robidev/mini_substation_automation/docs/hardware/hmi_pc/hmi_connections.txt

asus EEE pc
network-connection
power adapter

ram
disk
processor
