robidev/mini_substation_automation/docs/hardware/protection_relay/rpi_connections.txt

pinout serial(uart5)
pinout lcd (spi/i2c)
power
ethernet
