robidev/mini_substation_automation/docs/hardware/switchyard/rpi_connections.txt

servo hat
uart+gnd
14 outputs
10 servo's
5v psu
micro-usb
usb-a to arduino
