robidev/mini_substation_automation/docs/build_steps/2_mechanics/20250916_203245.min.jpg

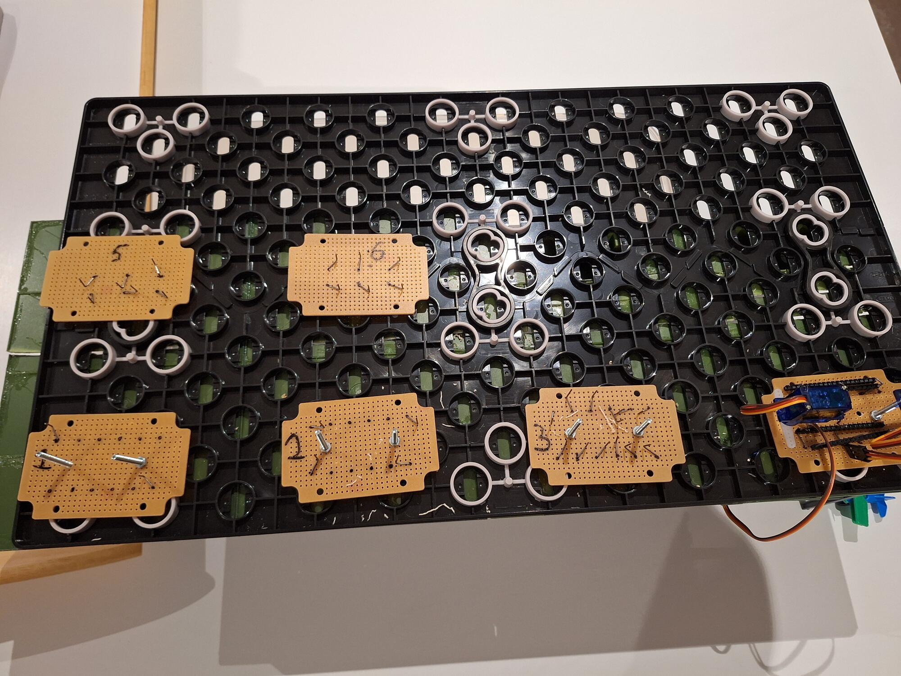
docs/build_steps/2_mechanics/20250916_203245.min.jpg
