robidev/mini_substation_automation/docs/build_steps/2_mechanics/20250917_221358.min.jpg

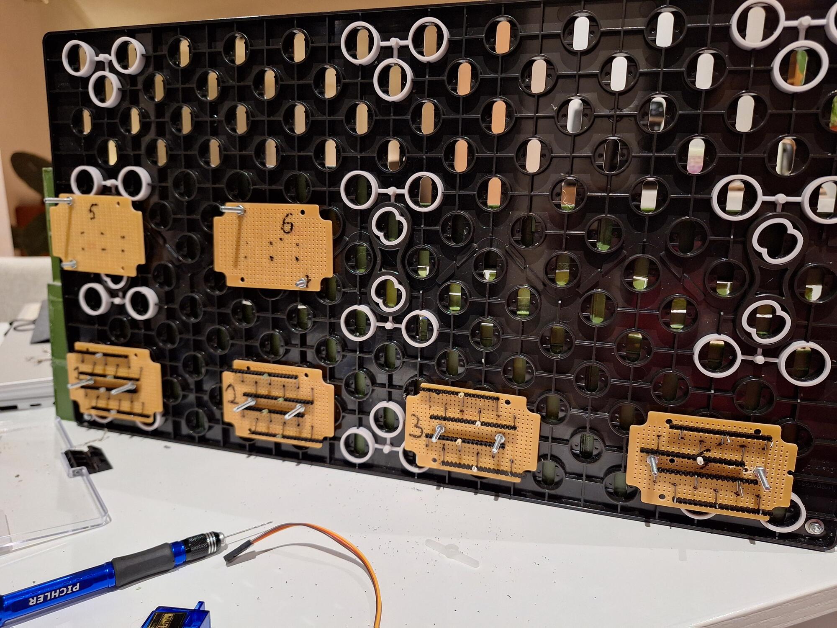
docs/build_steps/2_mechanics/20250917_221358.min.jpg
