robidev/mini_substation_automation/docs/build_steps/4_electronics/20250921_212938.min.jpg

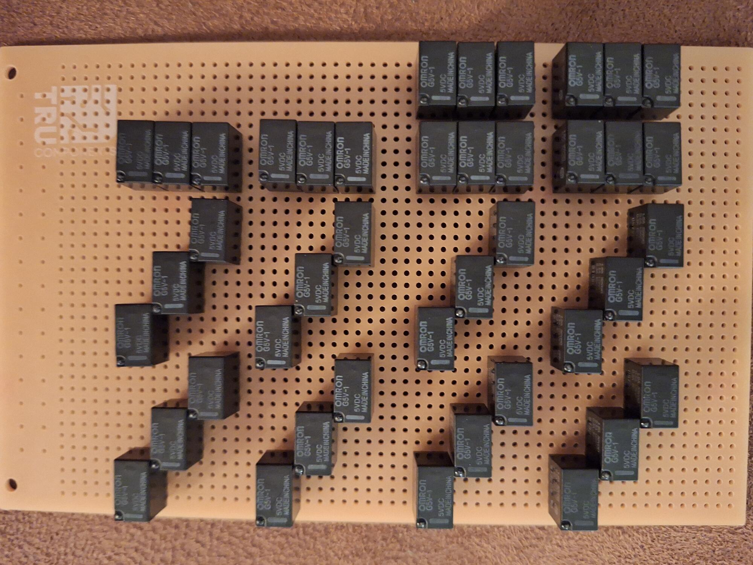
docs/build_steps/4_electronics/20250921_212938.min.jpg
