robidev/mini_substation_automation/docs/build_steps/4_electronics/20250926_090544.min.jpg

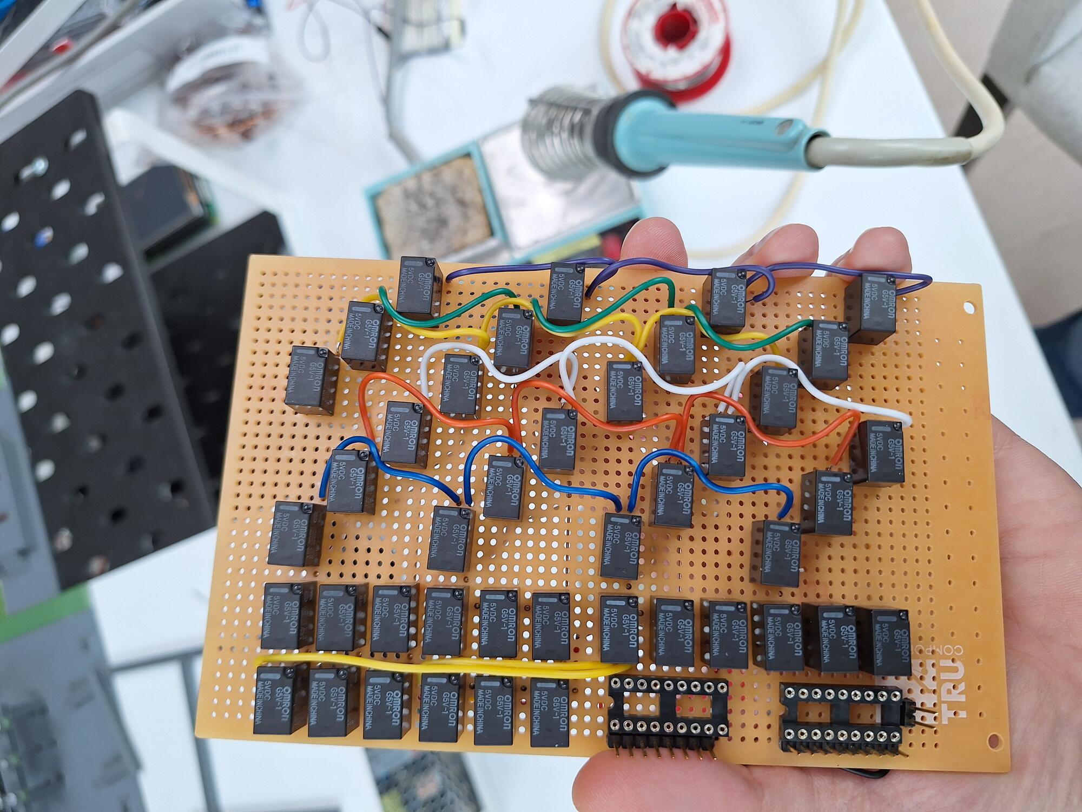
docs/build_steps/4_electronics/20250926_090544.min.jpg
