robidev/mini_substation_automation/docs/build_steps/4_electronics/20250927_000911.min.jpg

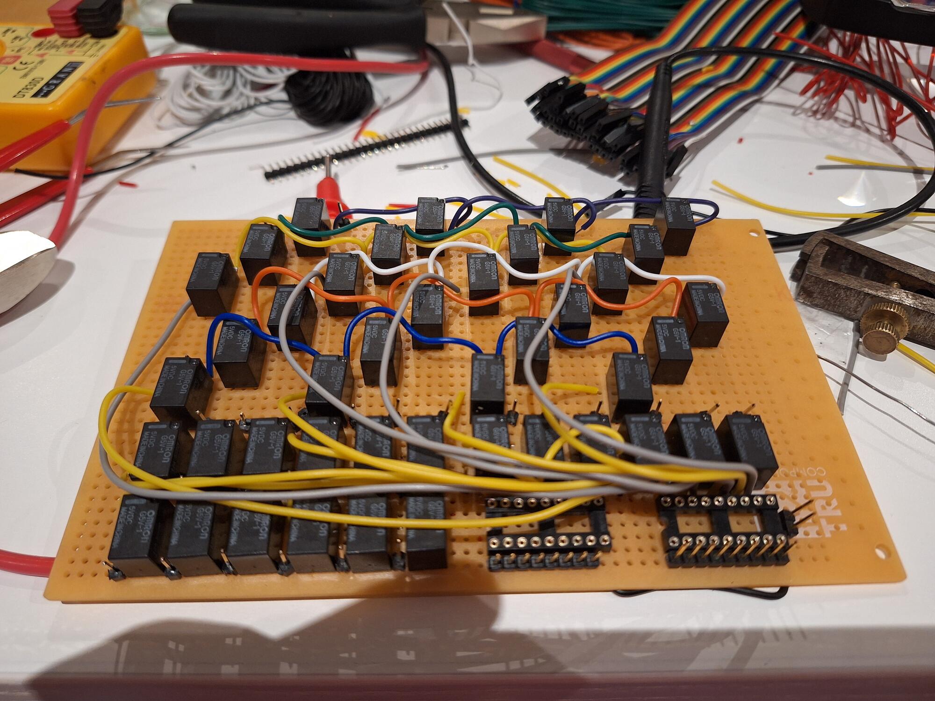
docs/build_steps/4_electronics/20250927_000911.min.jpg
