robidev/mini_substation_automation/docs/build_steps/4_electronics/20251019_193319.min.jpg

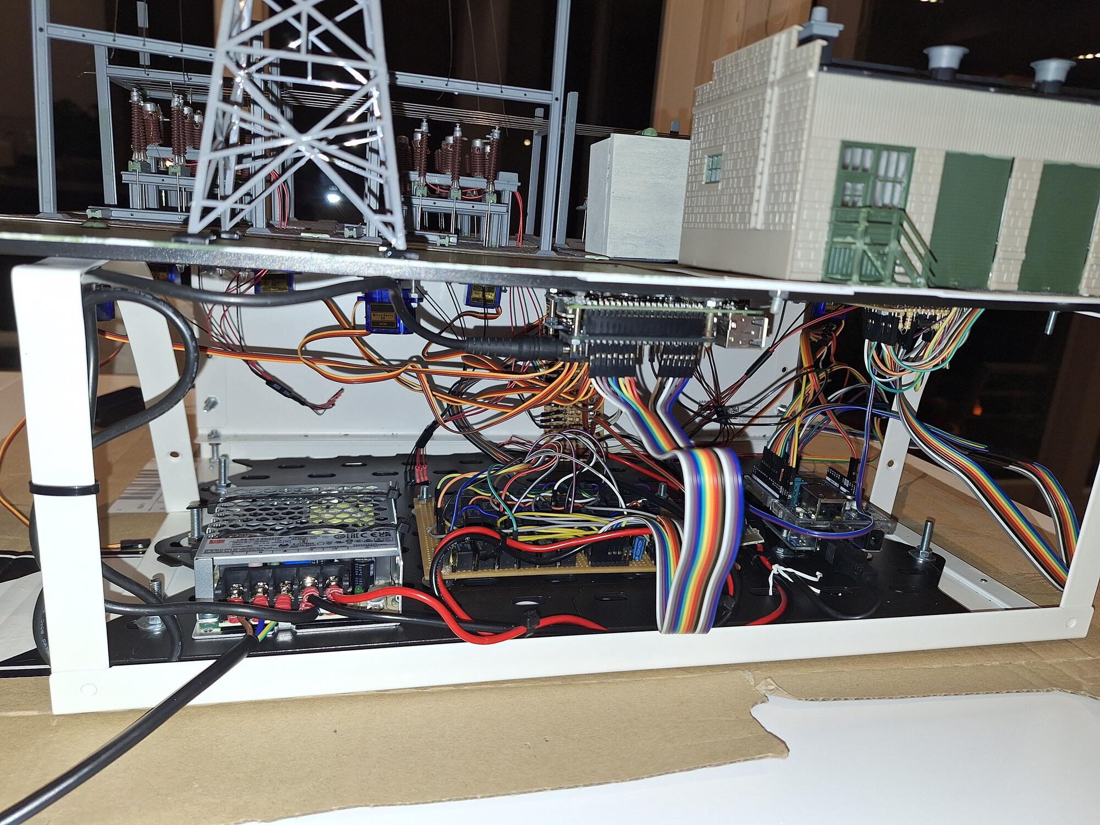
docs/build_steps/4_electronics/20251019_193319.min.jpg
