robidev/mini_substation_automation/docs/build_steps/4_electronics/20251230_195655.min.jpg

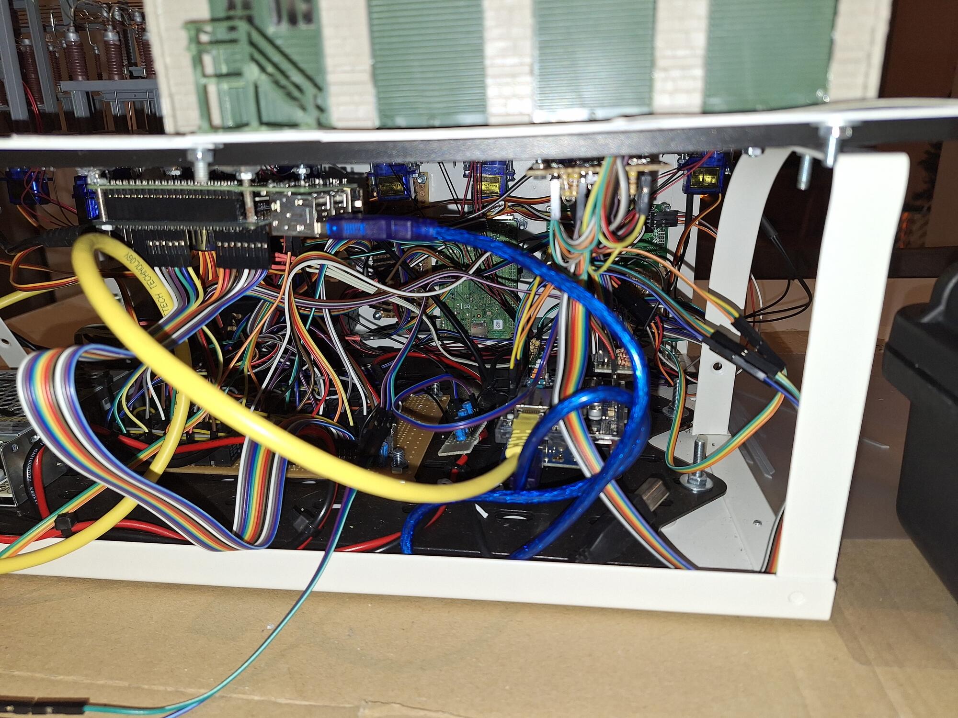
docs/build_steps/4_electronics/20251230_195655.min.jpg
