robidev/mini_substation_automation/docs/frontpanel_design/cuts_dimension/__MS_blue_126.238x49.953mm.png

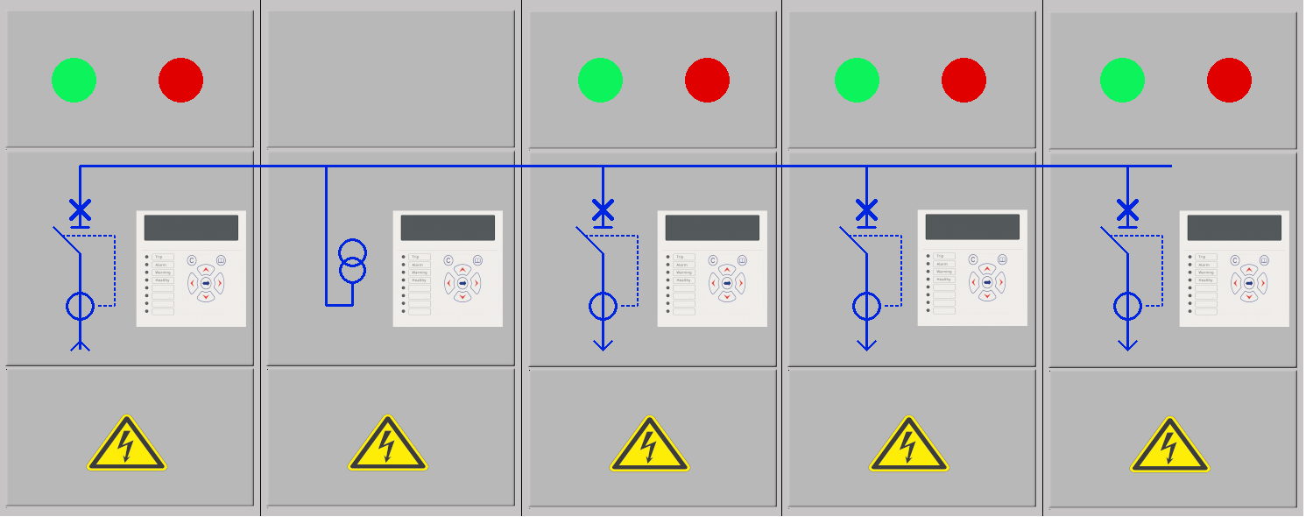
docs/frontpanel_design/cuts_dimension/__MS_blue_126.238x49.953mm.png
