robidev/mini_substation_automation/docs/frontpanel_design/cuts_dimension/__SAS_102.193x50.038mm.png

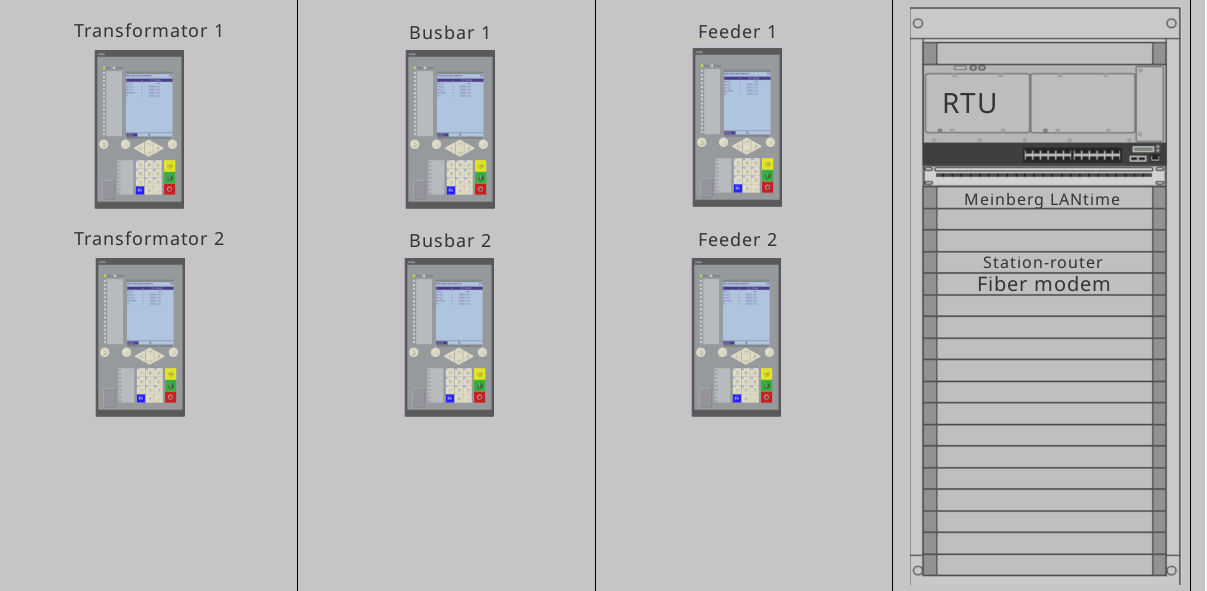
docs/frontpanel_design/cuts_dimension/__SAS_102.193x50.038mm.png
