robidev/mini_substation_automation/docs/frontpanel_design/cuts_dimension/cabinet_164.253x35.306mm.png

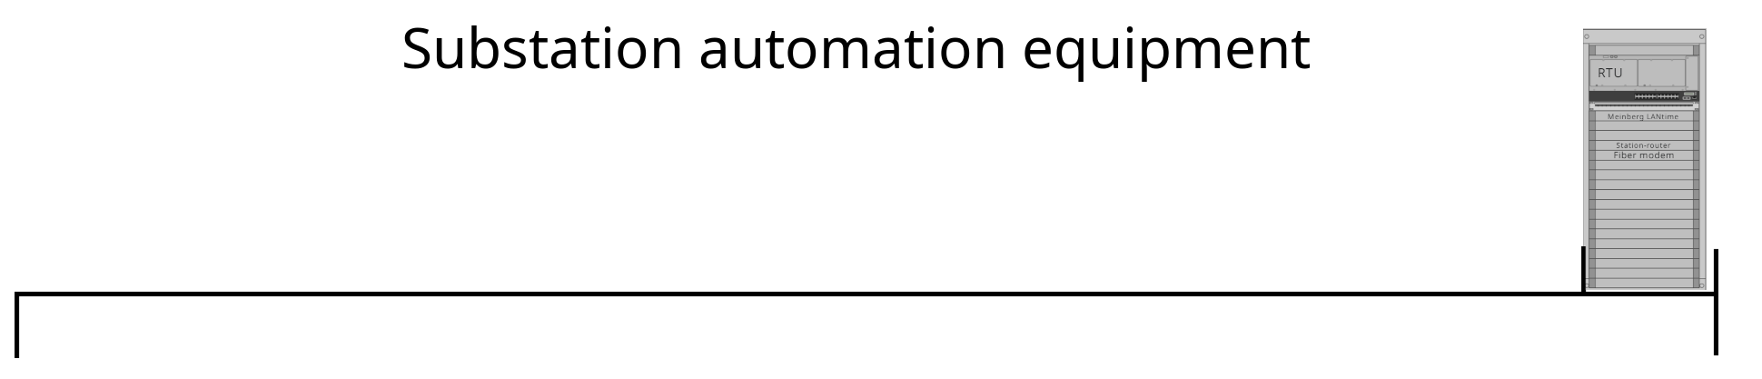
docs/frontpanel_design/cuts_dimension/cabinet_164.253x35.306mm.png
