robidev/mini_substation_automation/docs/frontpanel_design/cuts_dimension/door_b_21.929x46.905mm.png

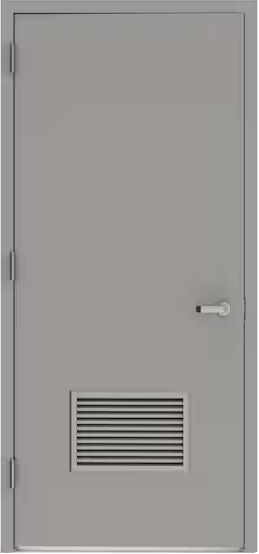
docs/frontpanel_design/cuts_dimension/door_b_21.929x46.905mm.png
