robidev/mini_substation_automation/docs/frontpanel_design/cuts_dimension/door_f_21.929x46.990mm.png

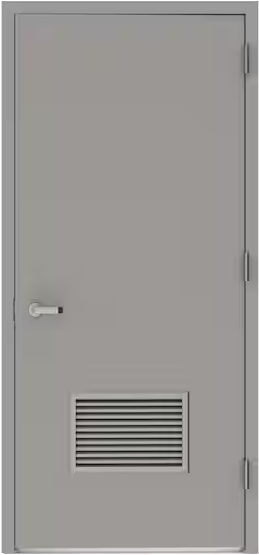
docs/frontpanel_design/cuts_dimension/door_f_21.929x46.990mm.png
