robidev/mini_substation_automation/docs/frontpanel_design/cuts_dimension/hv_relay_img_50.292x26.331mm.png

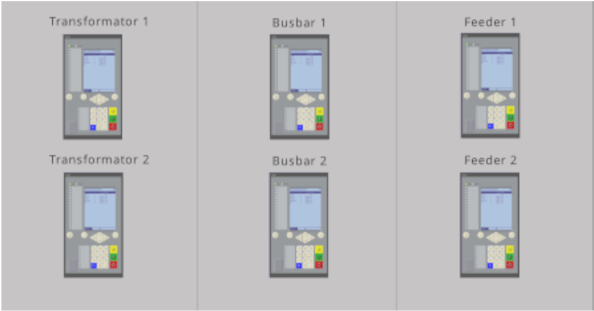
docs/frontpanel_design/cuts_dimension/hv_relay_img_50.292x26.331mm.png
