robidev/mini_substation_automation/docs/frontpanel_design/cuts_dimension/micom_73.914x76.793mm.png

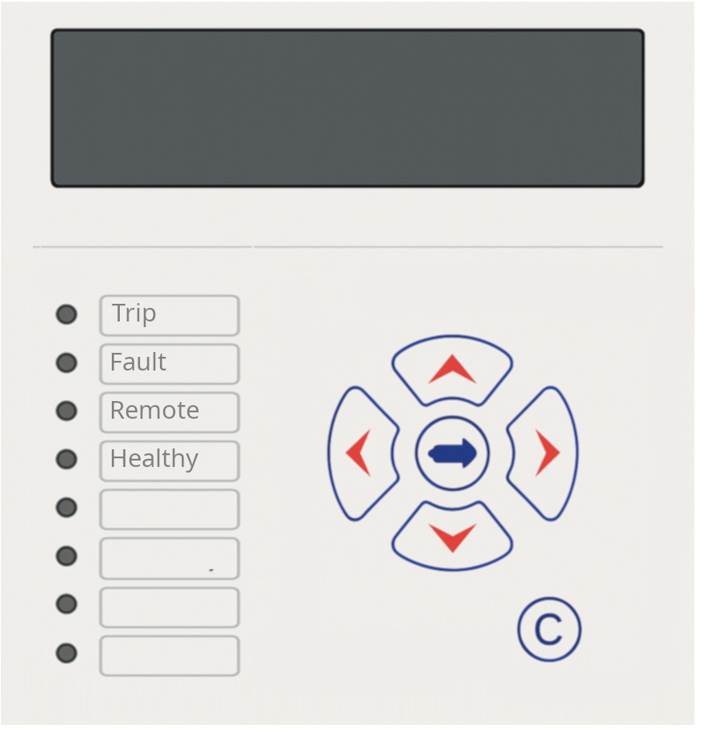
docs/frontpanel_design/cuts_dimension/micom_73.914x76.793mm.png
