robidev/mini_substation_automation/docs/frontpanel_design/cuts_dimension/micom_blue_35.306x14.478mm.png

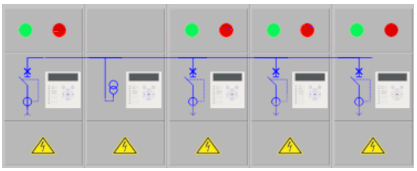
docs/frontpanel_design/cuts_dimension/micom_blue_35.306x14.478mm.png
