robidev/mini_substation_automation/docs/frontpanel_design/cuts_dimension/micom_red_35.306x14.224mm.png

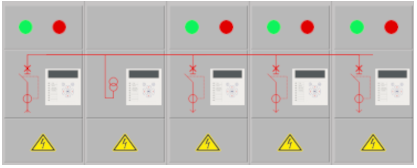
docs/frontpanel_design/cuts_dimension/micom_red_35.306x14.224mm.png
