robidev/mini_substation_automation/docs/frontpanel_design/cuts_dimension/output_img_30.057x108.289mm.png

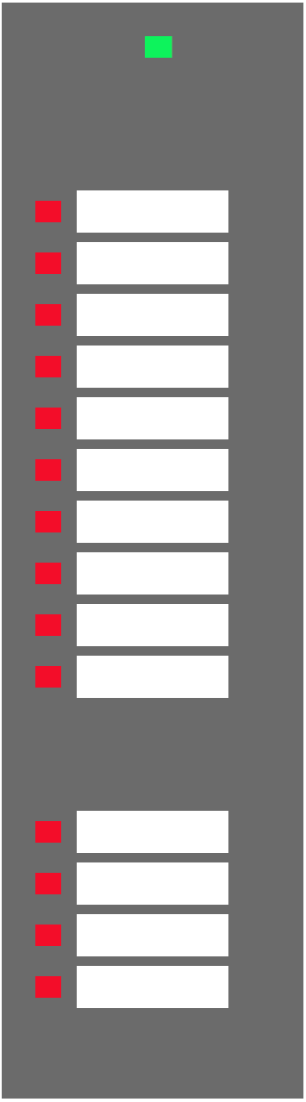
docs/frontpanel_design/cuts_dimension/output_img_30.057x108.289mm.png
