robidev/mini_substation_automation/docs/frontpanel_design/cuts_dimension/rtu_158.411x29.379mm.png

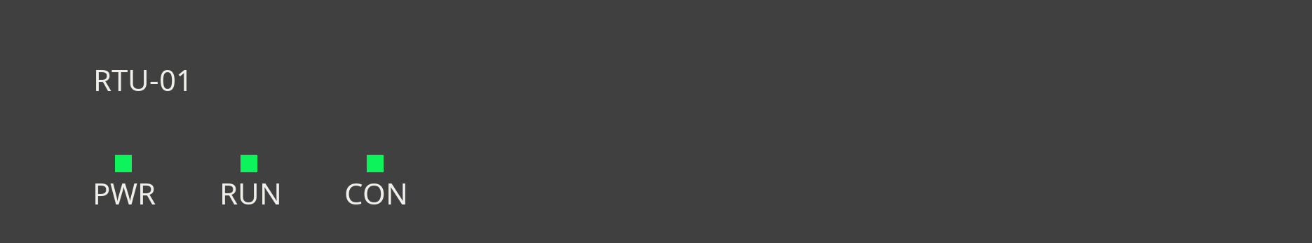
docs/frontpanel_design/cuts_dimension/rtu_158.411x29.379mm.png
