robidev/mini_substation_automation/docs/frontpanel_design/cuts_dimension/spare/hv_relay_62.992x38.100mm.png

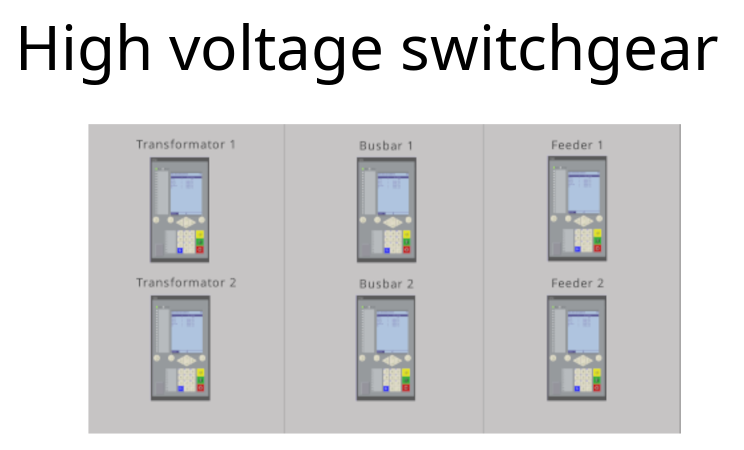
docs/frontpanel_design/cuts_dimension/spare/hv_relay_62.992x38.100mm.png
