robidev/mini_substation_automation/docs/frontpanel_design/cuts_dimension/spare/micom_text_74.253x30.903mm.png

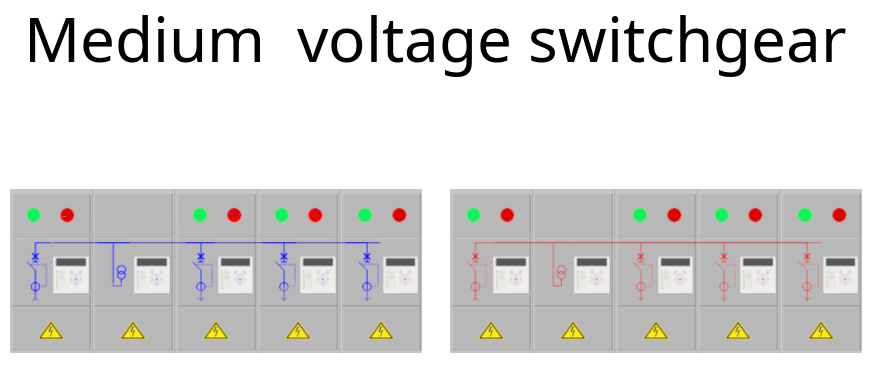
docs/frontpanel_design/cuts_dimension/spare/micom_text_74.253x30.903mm.png
