robidev/mini_substation_automation/docs/frontpanel_design/front_411.988x135.975mm.png

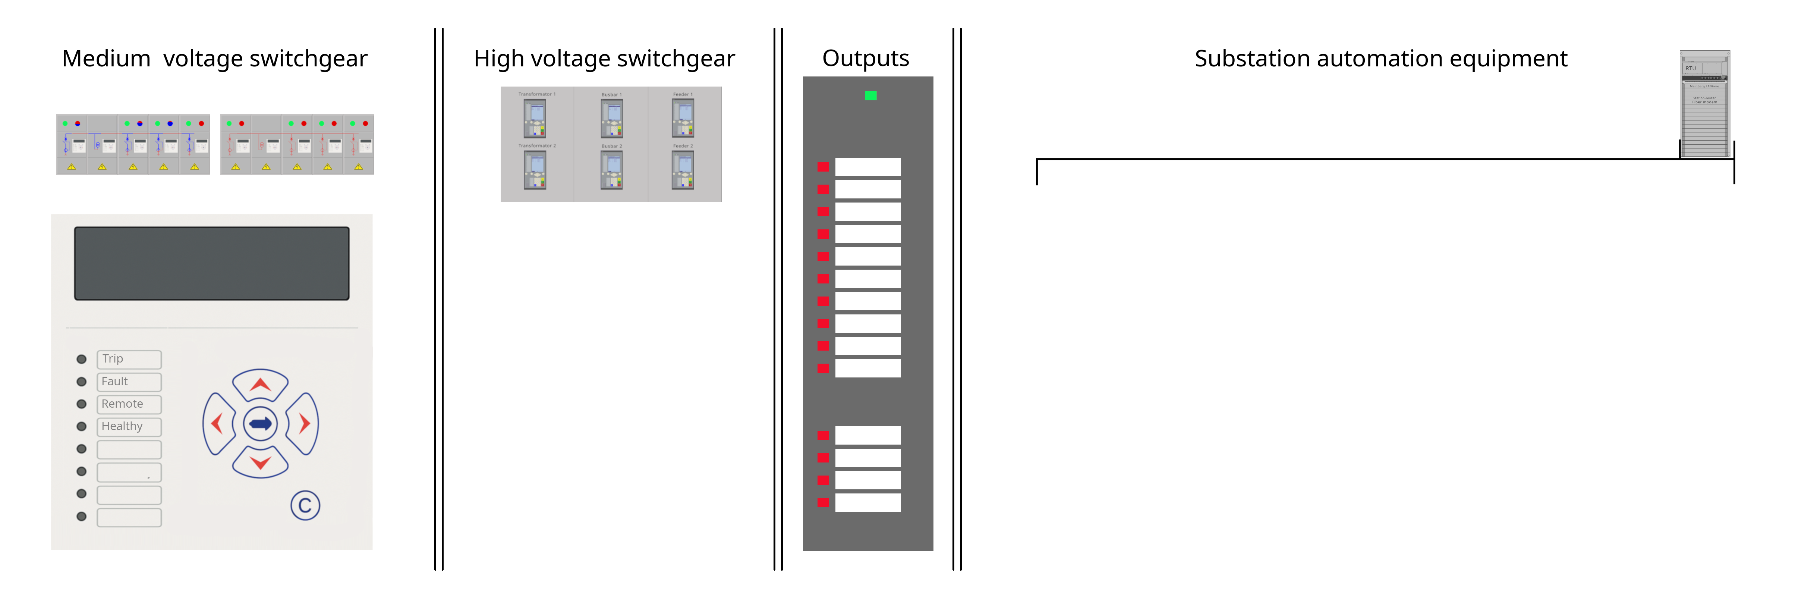
docs/frontpanel_design/front_411.988x135.975mm.png
