robidev/mini_substation_automation/docs/frontpanel_design/stickervel.png

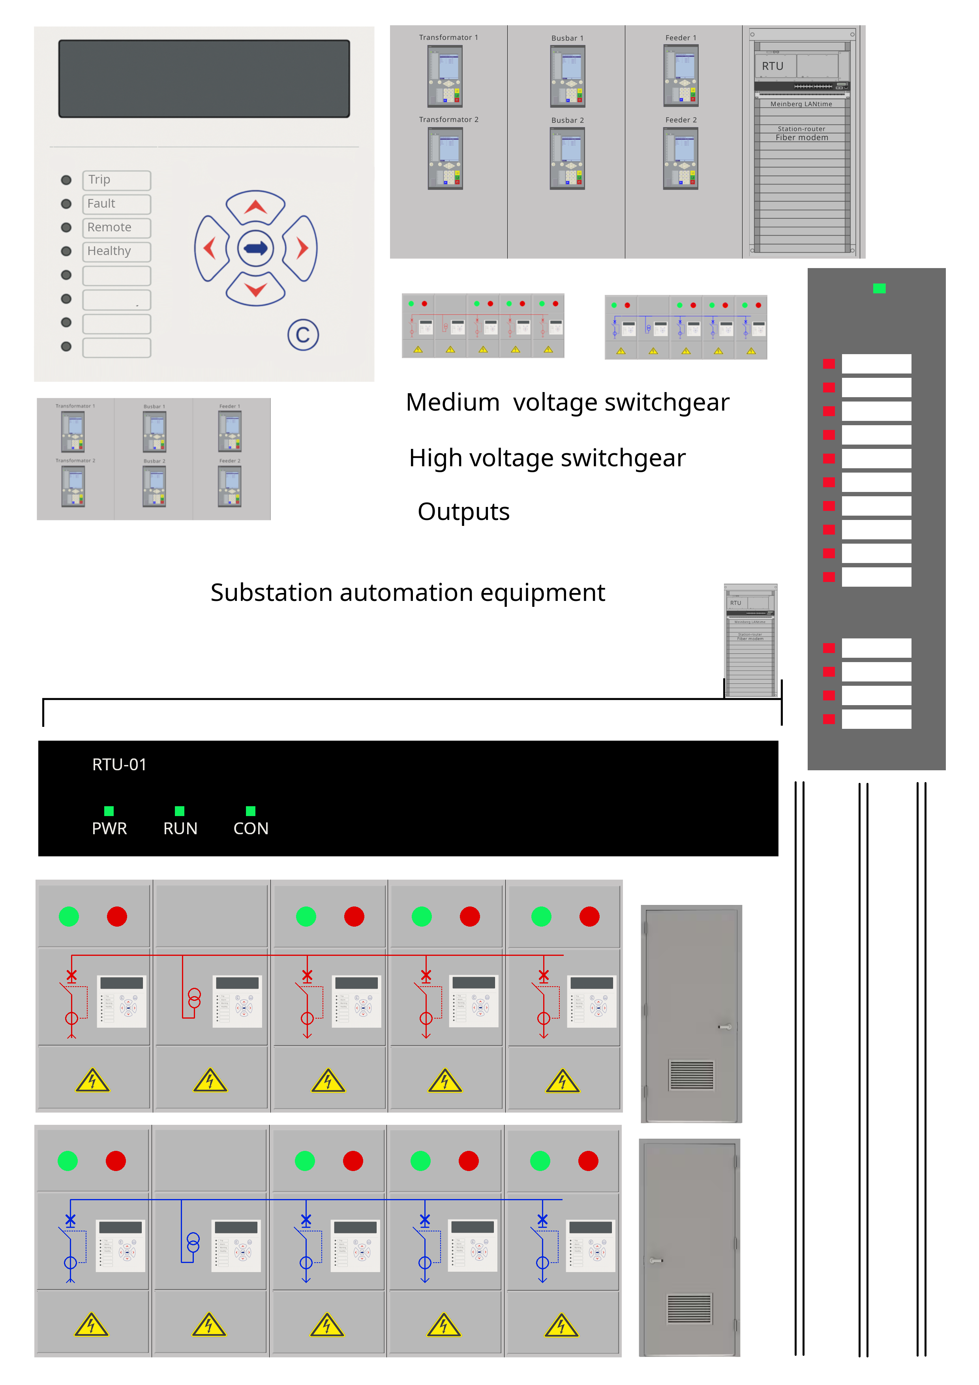
docs/frontpanel_design/stickervel.png
