robidev/mini_substation_automation/docs/reference_material/Arduino-Mega-2560-pinouts.webp

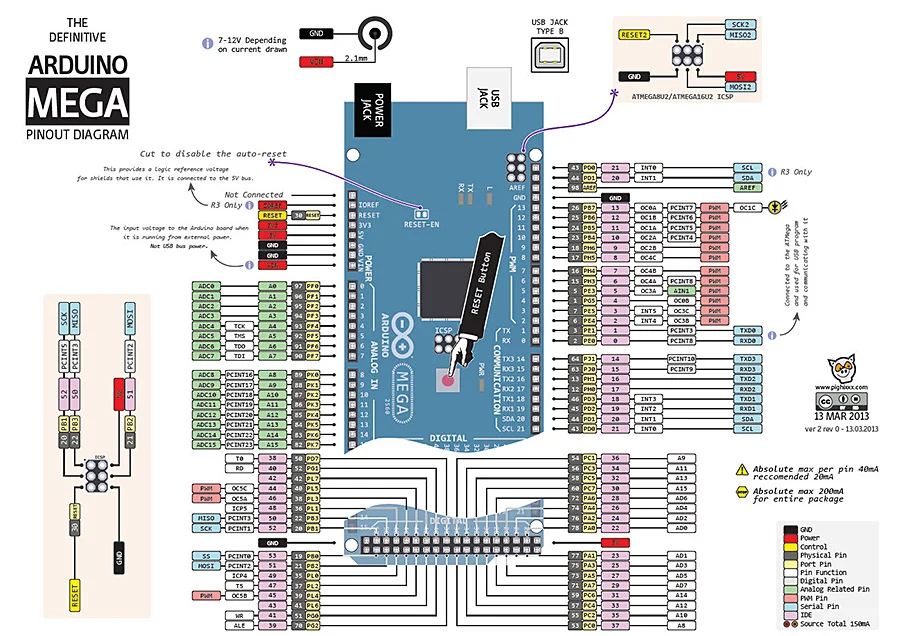
docs/reference_material/Arduino-Mega-2560-pinouts.webp
