robidev/mini_substation_automation/docs/build_steps/0_sets/bom3.png

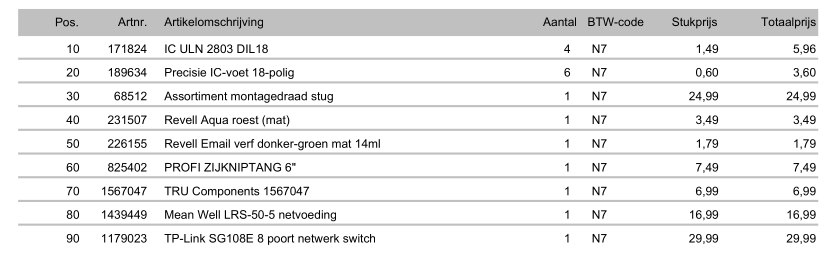
docs/build_steps/0_sets/bom3.png
