robidev/mini_substation_automation/docs/reference_material/661fd490736642a1cacd855f_technologists-industrial-solutions-service-solutions-for-medium-voltage-switchgear-large.min.jpg

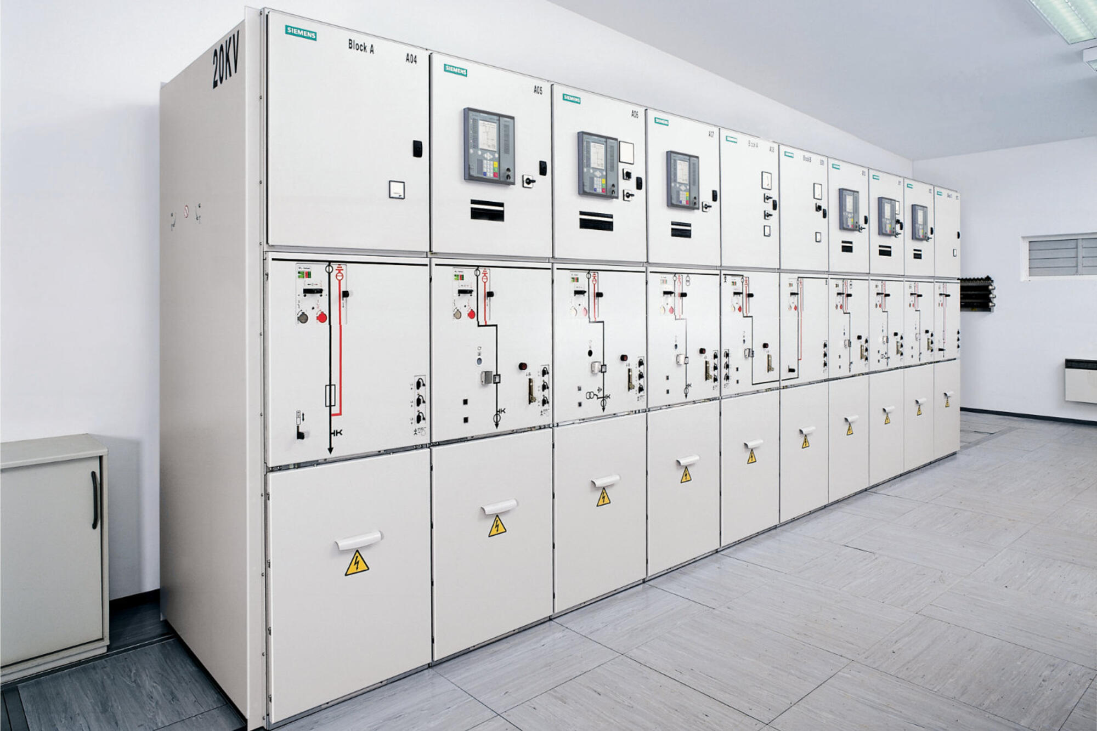
docs/reference_material/661fd490736642a1cacd855f_technologists-industrial-solutions-service-solutions-for-medium-voltage-switchgear-large.min.jpg
