robidev/mini_substation_automation/docs/reference_material/menu2.png

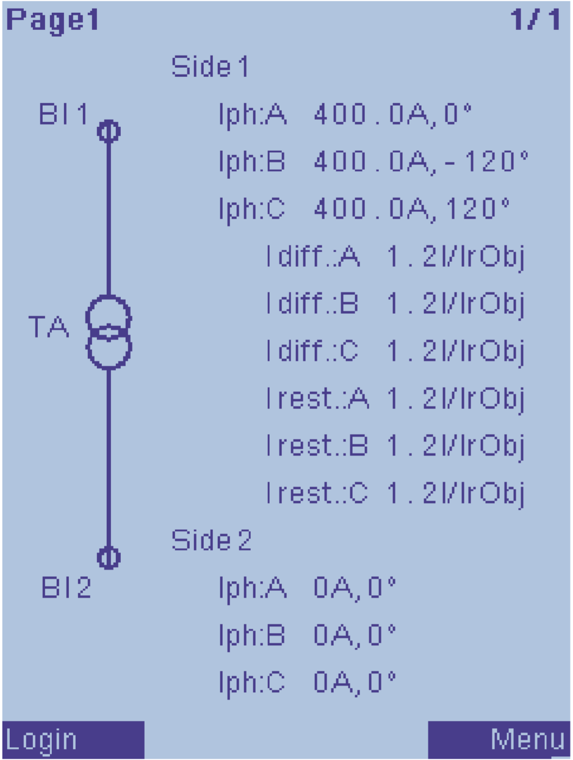
docs/reference_material/menu2.png
