robidev/mini_substation_automation/docs/reference_material/menu.png

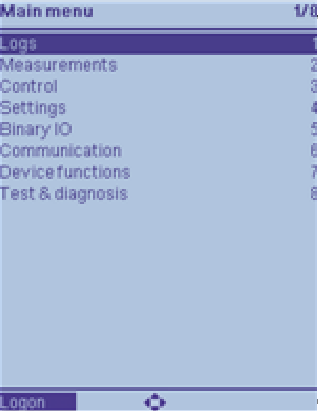
docs/reference_material/menu.png
