robidev/mini_substation_automation/docs/reference_material/Protection-Relay-Protective-11kv-22kv-33kv-2.min.jpg

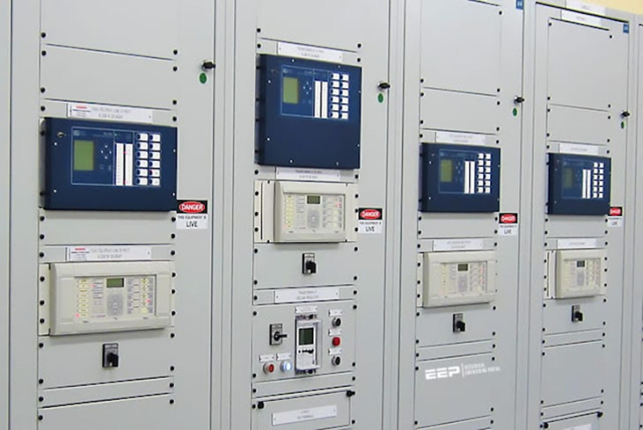
docs/reference_material/Protection-Relay-Protective-11kv-22kv-33kv-2.min.jpg
