robidev/mini_substation_automation/docs/reference_material/Screenshot 2025-10-21 211050.png

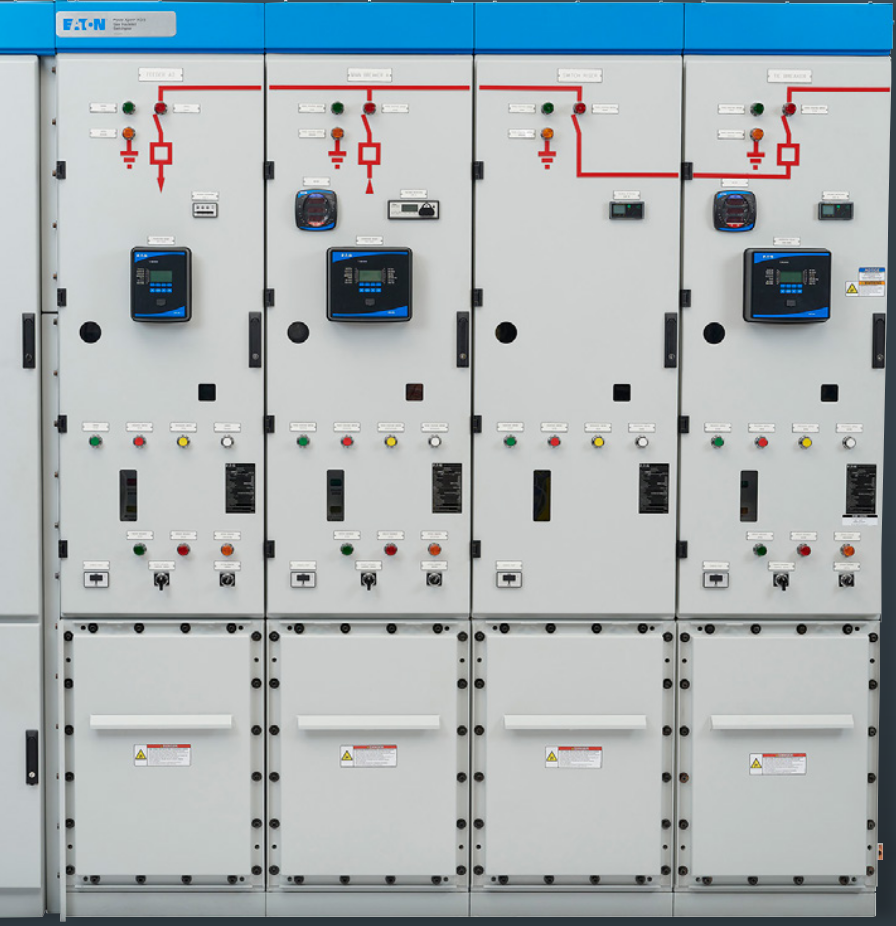
docs/reference_material/Screenshot 2025-10-21 211050.png
