robidev/mini_substation_automation/docs/reference_material/Screenshot 2025-10-21 212110.png

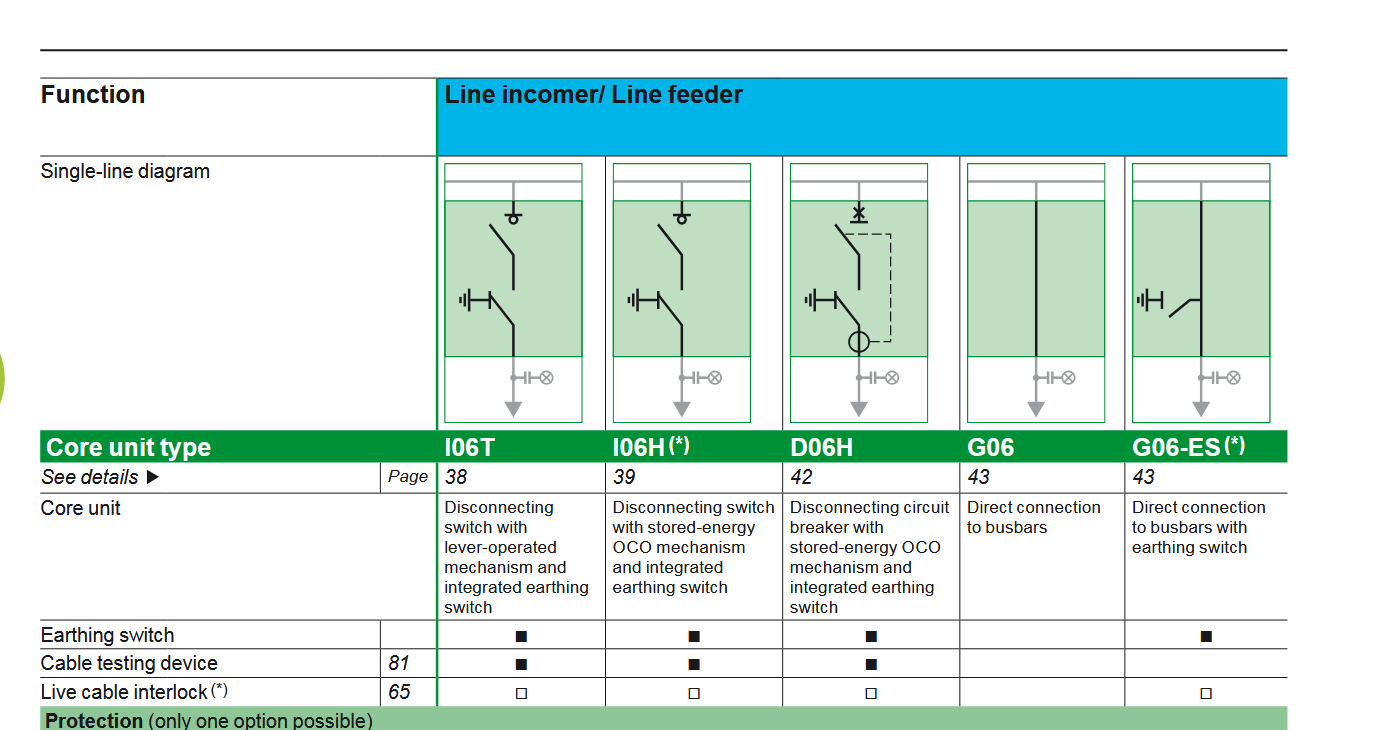
docs/reference_material/Screenshot 2025-10-21 212110.png
