robidev/mini_substation_automation/docs/reference_material/Screenshot 2025-10-21 212143.png

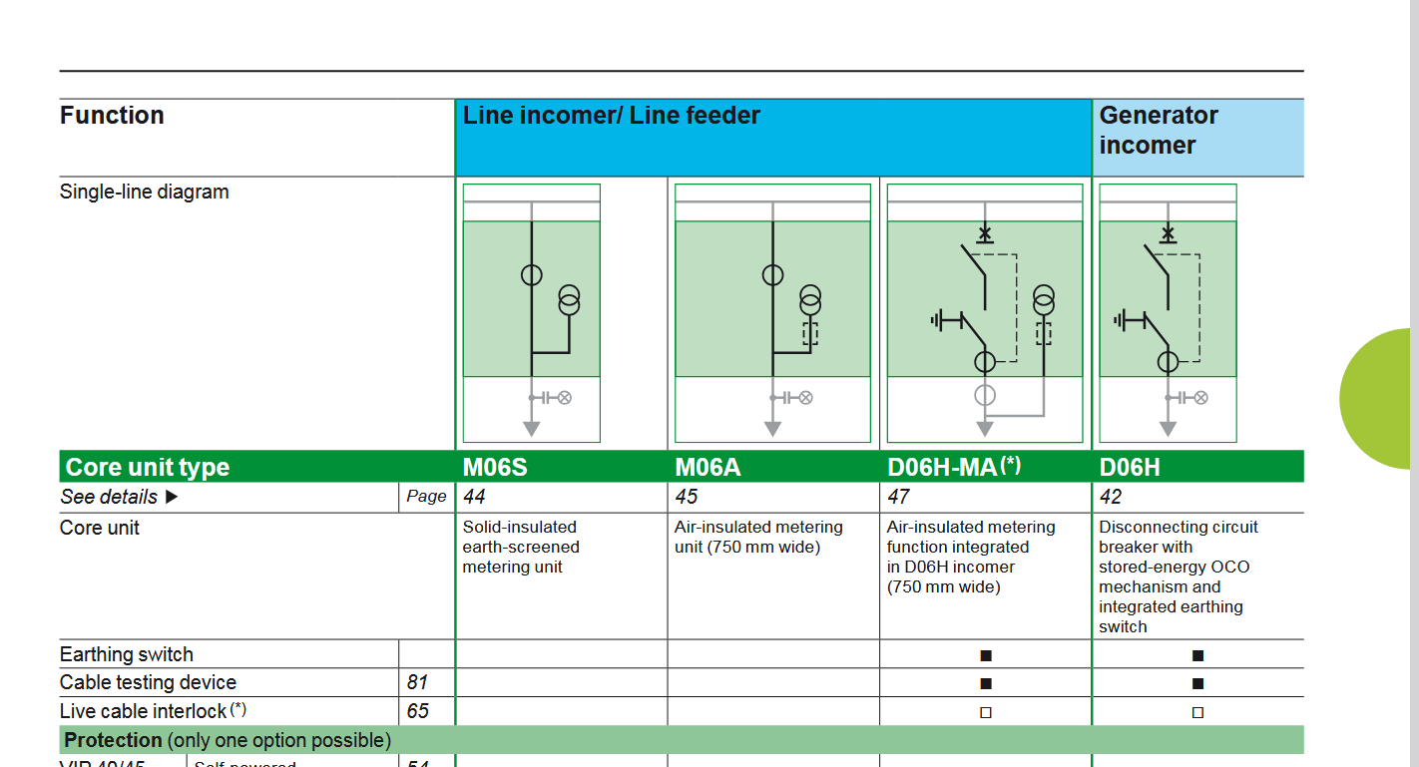
docs/reference_material/Screenshot 2025-10-21 212143.png
