robidev/mini_substation_automation/docs/reference_material/Screenshot 2025-11-23 000049.png

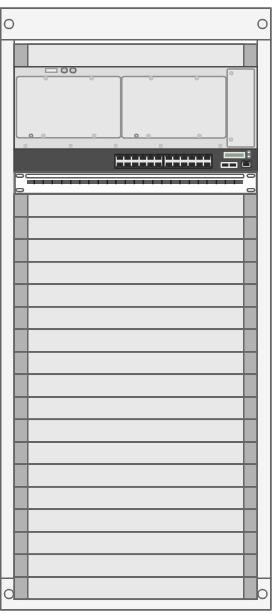
docs/reference_material/Screenshot 2025-11-23 000049.png
