robidev/mini_substation_automation/docs/reference_material/siprotec2.png

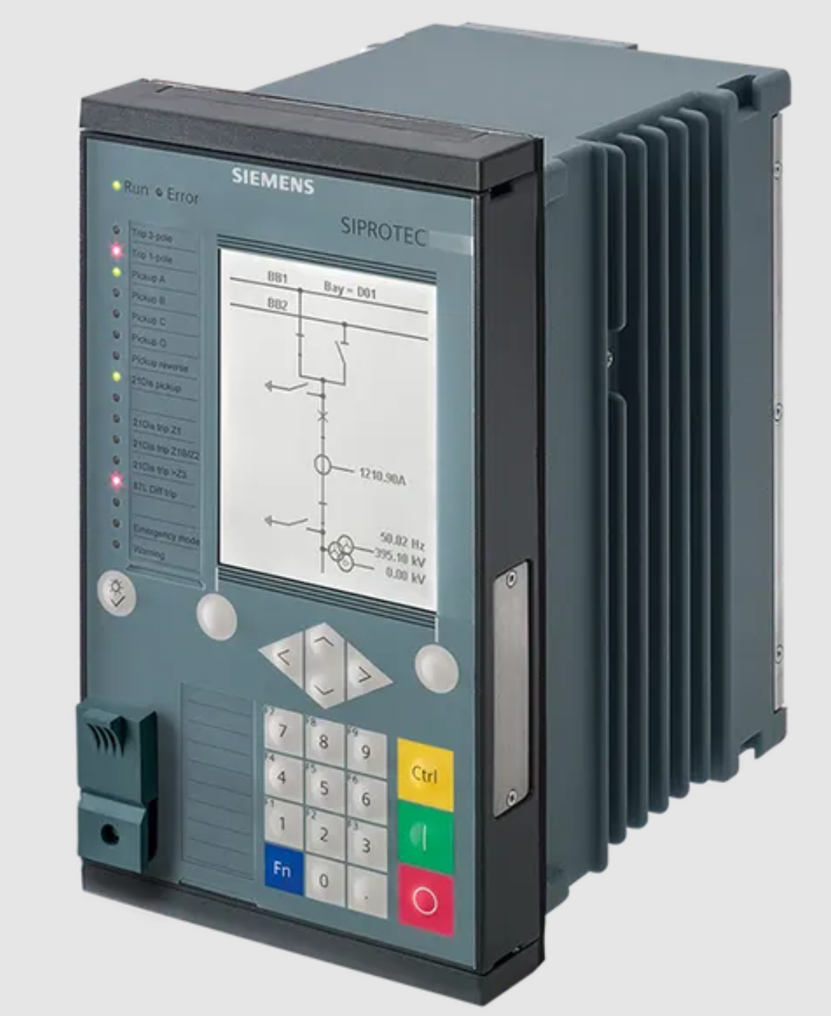
docs/reference_material/siprotec2.png
