robidev/mini_substation_automation/docs/reference_material/siprotec.png

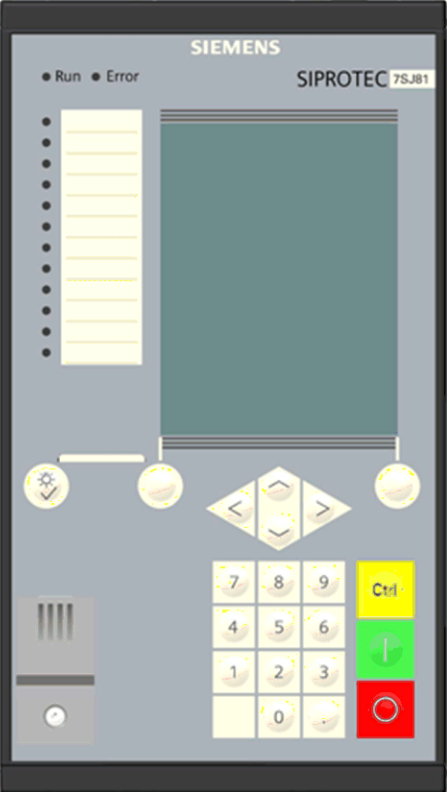
docs/reference_material/siprotec.png
