robidev/mini_substation_automation/docs/Manual/relay_manual.docx

Protection Relay Simulator

User Manual

Platform: Arduino Mega 2560

Hardware: 2×16 I²C LCD • 6 Charlieplexed Buttons • 4 Status LEDs

Communications: Modbus TCP / Ethernet (W5500)

Version: 1.0 | 2026

# 1. System Overview

This device is an Arduino-based protection relay simulator designed for educational and test-bench use. It replicates the behaviour of a real medium-voltage protection relay panel covering two independent busbars ("blue" and "red"), each with one incoming feeder, one bus-voltage measurement point, and three outgoing bay feeders.

The unit accepts analogue voltage and current signals, evaluates protection functions, drives digital breaker outputs, and exposes its full register map over Modbus TCP so that a SCADA or test PC can monitor and control it remotely.

## 1.1 Hardware at a Glance

Component | Detail
Microcontroller | Arduino Mega 2560
Display | 16-character × 2-line LCD, I²C address 0x27 (SDA D20, SCL D21)
Buttons | 6 buttons charlieplexed on 3 GPIO pins (D11, D12, D13): Up, Down, Left, Right, Enter, Cancel
Status LEDs | 4 × green LED (D49–D46): Trip, Alarm, Local/Remote, Healthy
Analogue inputs | 12 channels: A0–A5 (CT inputs, feeds 1–2), A8–A13 (VT inputs, busbars 1–2)
Breaker outputs | 10 digital outputs simulating LED-coupled breaker positions (5 per busbar)
Ethernet | W5500 module, SPI (D10 CS, D50–52). Default static IP 172.16.1.12, port 502

## 1.2 RTU Layout

The firmware models 10 Remote Terminal Units (RTUs), grouped in two busbars of 5 each:

# | Name | Type | Menu

1 | Feed RTU blue | Incoming relay | Full RTU menu
2 | Bus Voltage blue | Voltage measurement | Measure menu only
3 | Bay RTU blue-1 | Outgoing relay | Full RTU menu
4 | Bay RTU blue-2 | Outgoing relay | Full RTU menu
5 | Bay RTU blue-3 | Outgoing relay | Full RTU menu
6 | Feed RTU red | Incoming relay | Full RTU menu
7 | Bus Voltage red | Voltage measurement | Measure menu only
8 | Bay RTU red-1 | Outgoing relay | Full RTU menu
9 | Bay RTU red-2 | Outgoing relay | Full RTU menu
10 | Bay RTU red-3 | Outgoing relay | Full RTU menu

# 2. Front Panel Controls & Indicators

## 2.1 Status LEDs

The four LEDs on the front panel indicate the current operational state. When you are in the Main Menu (no RTU selected), all three status LEDs are off; only Healthy stays on. As soon as an RTU is selected, the LEDs reflect that specific RTU.

LED | Colour | State | Meaning
TRIP | Green | ON | The selected RTU is in a tripped state. The breaker has been opened by protection.
ALARM | Green | ON | A fault condition is active on the selected RTU (overcurrent pickup detected).
Local/Remote | Green | ON | The selected RTU is in Remote control mode. When off, control is Local.
HEALTHY | Green | Always ON | Device is powered and firmware is running normally.

## 2.2 Buttons

Six buttons are arranged as a directional pad plus two action buttons. Because they are charlieplexed on only three signal lines, only one button may be pressed at a time; simultaneous presses produce undefined navigation.

Button | Function
▲ UP | Move selection one item backward in the current menu. Wraps around from first to last item.
▼ DOWN | Move selection one item forward. Wraps around from last to first.
◄ LEFT | Same as UP — alternative navigation within a menu.
► RIGHT | Same as DOWN — alternative navigation within a menu.
ENTER | Confirm the highlighted item. Enters a sub-menu, executes an action, or confirms a dialog.
CANCEL | Jump immediately back to the Main Menu from anywhere in the menu tree. If already at Main Menu, resets the selection to item 1 and clears the active RTU.

# 3. Menu System

The LCD shows two lines of 16 characters at all times. Navigation is cyclic within each menu level. The display refreshes every 50 ms. Menus are stored in flash (PROGMEM) to conserve RAM.

## 3.1 Menu Tree

The complete menu hierarchy is shown below. Items marked with [action] execute immediately on ENTER; items marked with [submenu] open a deeper level.

Level 1 — Main Menu | Level 2 — RTU Menu | Level 3 / Action
Feed RTU blue | Status | Shows breaker state, trip flag, fault flag
| Measurements | Shows I1, I2, I3, In (phase currents)
| Breaker Control | Open Breaker → confirm dialog
| | Close Breaker → confirm dialog
| | Reset Trip → confirm dialog
| Trip History | Last fault event type and timestamp
| Settings | Control Mode (toggle Local/Remote)
| About | Device number
Bus Voltage blue | Measurements | Shows U1, U2, U3, Un (phase voltages)
| About | Device number
Bay RTU blue-1/2/3 | (same as Feed RTU blue)
Feed RTU red | (same as Feed RTU blue)
Bus Voltage red | (same as Bus Voltage blue)
Bay RTU red-1/2/3 | (same as Feed RTU blue)

## 3.2 Main Menu

At power-on the device starts at the Main Menu. The top LCD row shows a cursor indicator arrow over a position that corresponds to the currently highlighted RTU (positions 1–10). The bottom row shows the name of the highlighted RTU.

Example — RTU 1 highlighted: ^ Feed RTU blue The ^ symbol (custom up-arrow character) moves along the top line as you navigate through the 10 RTUs. | Example — RTU 6 highlighted: ^ Feed RTU red Press ENTER to select the highlighted RTU and enter its sub-menu.

Bus Voltage RTUs (positions 2 and 7) have a reduced menu: only Measurements and About are available.

## 3.3 RTU Main Menu

After selecting an RTU, the screen shows the RTU sub-menu. The top row displays the menu title; the bottom row shows "> " followed by the currently selected item name.

Main RTU Menu

> Status

Navigate with UP/DOWN and press ENTER to open the desired function.

Available items for relay RTUs:

- Status
- Measurements
- Breaker Control
- Trip History
- Settings
- About
- Back (returns to Main Menu, keeps RTU position)

Available items for voltage measurement RTUs:

- Measurements
- About
- Back

# 4. Functions in Detail

## 4.1 Status

Displays the current breaker position, trip flag and fault flag of the selected RTU.

Breaker: CLOSED

Trip:N Fault:N

Possible breaker states:

- OPEN — breaker is open, no current flows
- CLOSED — breaker is closed and carrying load
- TRIPPED — protection has opened the breaker; a trip reset is required before re-closing

Trip (Y/N) and Fault (Y/N) are independent flags. A fault can be active without a trip if the current is only marginally above the pickup threshold and the time-multiplier has not yet been exceeded.

## 4.2 Measurements

### 4.2.1 Current Measurements (Relay RTUs)

Shows the three phase currents and the calculated neutral/residual current for relay-type RTUs. Values are derived from the analogue inputs scaled by the configured load impedances.

I1:120 I2:118

I3:119 In:2

I1, I2, I3 are the individual phase currents (in simulation units). In is the calculated residual current derived using the formula √(I1² + I2² + I3² − I1·I2 − I2·I3 − I3·I1). A non-zero residual may indicate a developing earth fault.

### 4.2.2 Voltage Measurements (Bus Voltage RTUs)

For Bus Voltage RTUs (RTU 2 and 7), the Measurements screen shows the three phase-to-reference voltages and the calculated neutral displacement voltage.

U1:2300 U2:2298

U3:2301 Un:3

Voltage values are read from analogue inputs A8–A13 at 100 Hz and updated continuously. They are only non-zero when the corresponding incoming feed breaker is closed.

## 4.3 Breaker Control

Allows the operator to command the breaker Open, Closed, or to reset a trip. Each command opens a confirmation dialog before executing, preventing accidental operation.

### 4.3.1 Confirmation Dialog

When a breaker command is selected, the display changes to a confirm screen:

[Open Breaker]

<OK> Cancel

The top row shows the requested action in brackets. The bottom row offers OK or Cancel.

- Navigate LEFT/RIGHT (or UP/DOWN) to toggle between OK and Cancel.
- Press ENTER to confirm or cancel.

### 4.3.2 Open Breaker

Opens the breaker if it is currently closed. If the breaker is already open, the operation is rejected:

operation failed

already open

### 4.3.3 Close Breaker

Closes the breaker only when all of the following conditions are met:

1. Breaker is currently open
1. No active trip (tripState = false)
2. No active fault (faultState = false)

If any condition is not met, a descriptive error is shown for 5 seconds:

operation failed

reset trip first

operation failed

fault not clear

### 4.3.4 Reset Trip

Clears the trip flag so the breaker can be re-closed. Conditions:

3. A trip must be active (tripState = true)
4. No active fault (faultState = false) — the underlying fault must have cleared first

Trip reset is only permitted via the local panel when the RTU is in Local mode. In Remote mode, trip reset must be issued via Modbus TCP. See Section 6 for details.

### 4.3.5 Success Confirmation

When a command executes successfully, the display shows a confirmation message for 5 seconds before returning to the Breaker Control menu:

Action executed

succesfull

## 4.4 Trip History

Displays the type and approximate timestamp of the most recent protection trip.

Last Trip:Phase

Time: 45231ms

Fault event types:

- None — no trip has occurred since last power-up
- Phase OC — Phase overcurrent (PTOC — time-delayed trip)
- Earth — Earth fault / Instantaneous overcurrent (PIOC — immediate trip)

The time shown is the value of the Arduino millisecond counter at the moment the trip was registered, not an absolute clock time.

## 4.5 Settings — Control Mode

Toggles the RTU between Remote and Local control mode. The current selection is shown immediately after toggling.

Control:

Remote

In Remote mode the Remote LED is illuminated. Remote mode allows Modbus TCP commands to control the breaker. In Local mode, all control must be done through the front panel.

The default mode at power-up is Remote for all RTUs.

## 4.6 About

Shows the device (RTU) number and a copyright notice.

Device No. 1

(c) 2026

# 5. Protection Logic

The relay logic runs at 2 Hz (every 500 ms). Two protection functions are implemented for both incoming and outgoing relay RTUs:

## 5.1 PIOC — Instantaneous Overcurrent

If the measured current on any phase meets or exceeds the Instantaneous Pickup Current threshold, the RTU trips immediately on the next logic cycle without any time delay.

Parameter | Default Value
PIOC Pickup Current | 50 000 units (5000.0 A equivalent)
Trip delay | None — immediate
Fault event recorded | Earth_fault

## 5.2 PTOC — Time-Overcurrent

If the current exceeds the PTOC Pickup threshold but is below the PIOC threshold, a timer accumulates proportionally to the ratio of measured current to pickup current. When the timer value exceeds the Time Multiplier Setting, a time-delayed trip is issued.

Parameter | Default Value
PTOC Pickup Current | 5 000 units (500.0 A equivalent)
Time Multiplier Setting | 15 (0.15–0.25 equivalent)
Fault event recorded | Phase_OC
Timer reset | Immediately when current drops below pickup (no cool-off period)

## 5.3 Incoming Feeder Simulation

The incoming relay (RTU 1 / RTU 6) automatically sums the measured phase currents of all three connected outgoing bay relays on the same busbar. This models the physical reality that the incoming feeder carries the total load current of all bays. Both protection functions then evaluate this aggregated current against the incoming relay's own settings.

## 5.4 Voltage Measurement Simulation

The bus-voltage measurement RTU (RTU 2 / RTU 7) reads three ADC channels to determine phase voltages. Voltage is only non-zero when the corresponding incoming breaker is closed. The neutral displacement voltage Un is calculated geometrically from the three phase values.

# 6. Modbus TCP Interface

The device acts as a Modbus TCP server on port 502. Up to 8 simultaneous client connections are supported. The Unit ID in each Modbus request selects which RTU is being addressed (Unit ID 1 = RTU 1, Unit ID 10 = RTU 10).

Network configuration:

- MAC address: DE:AD:BE:EF:00:01
- Default IP: 172.16.1.12 (static; DHCP disabled by default)
- Port: 502

## 6.1 Input Registers (Read Only) — FC 04

Input registers reflect live device state. They are updated every time a Modbus request is received.

Address | Wire# | Reg Name | Range | Description
30001 | 00 | Breaker State | 1=Open, 2=Closed | Current breaker position
30002 | 01 | Trip State | 0/1 | 1 = tripped
30003 | 02 | Fault State | 0/1 | 1 = fault active
30004 | 03 | Control Mode | 1=Local, 2=Remote | Current Local/Remote mode
30005 | 04 | Device Type | 0/1/2 | 0=Incoming, 1=Measure, 2=Outgoing
30006 | 05 | Device Index | 0–9 | Internal RTU index (0-based)
30011 | 10 | Phase I1 / U1 | 0–65535 | Phase 1 current or voltage
30012 | 11 | Phase I2 / U2 | 0–65535 | Phase 2 current or voltage
30013 | 12 | Phase I3 / U3 | 0–65535 | Phase 3 current or voltage
30014 | 13 | Neutral In / Un | 0–65535 | Calculated neutral/residual
30031 | 30 | Fault Event | 0/1/2 | 0=None, 1=Phase OC, 2=Earth fault
30032 | 31 | Fault Time | 0–65535 | millis() at time of last trip (16-bit)
30041 | 40 | PIOC Pickup | 0–65535 | Instantaneous pickup current setting
30042 | 41 | PTOC Pickup | 0–65535 | Time-overcurrent pickup current setting
30043 | 42 | PTOC TMS | 0–65535 | Time multiplier setting

Voltage measurement RTUs (Unit IDs 2 and 7) populate registers 30021–30024 with voltage values instead; all breaker-related registers (30001–30004) read as 0.

## 6.2 Holding Registers (Read/Write) — FC 03 / 06 / 16

Write a non-zero value to issue a command. The register is automatically cleared to 0 after each request is processed.

Address | Wire# | Command | Values
40001 | 00 | Breaker Control | 0 = No action | 1 = Open | 2 = Close
40002 | 01 | Trip Reset | 0 = No action | 1 = Reset trip
40004 | 03 | Control Mode | 0 = No action | 1 = Set Local | 2 = Set Remote

Breaker and trip-reset commands via Modbus are only executed if the RTU is in Remote mode. Control mode changes (register 40004) are always accepted regardless of current mode.

# 7. Step-by-Step Operating Procedures

## 7.1 Power-up

5. Connect power to the Arduino. The Healthy (green) LED illuminates.
6. The LCD shows “Initialising...” briefly.
7. The Main Menu appears. All RTUs default to Remote mode with breakers open.
8. If an Ethernet cable is connected, the device attempts to bring up the W5500. A static IP of 172.16.1.12 is used. Modbus TCP is available once the link is up.

## 7.2 Monitoring an RTU

9. At the Main Menu, press DOWN/UP to highlight the desired RTU name on the bottom LCD row.
10. Press ENTER. The RTU sub-menu appears. Status LEDs update to reflect this RTU.
11. Highlight “Status” and press ENTER to see the breaker position, trip and fault flags.
12. Press CANCEL at any time to return to the Main Menu.

## 7.3 Closing a Breaker (Local)

13. Select the target RTU from the Main Menu.
14. Navigate to Settings > Control Mode and verify the display shows “Local”. If it shows “Remote”, press ENTER to toggle it to Local.
15. Navigate to Breaker Control > Close Breaker.
16. The confirmation dialog appears. Navigate to “<OK>” and press ENTER.
17. If successful, “Action executed / succesfull” is shown for 5 seconds, then the menu returns.
18. Verify the new state via Status.

## 7.4 Clearing a Trip (Local)

19. Select the tripped RTU. The TRIP LED is on.
20. Navigate to Status. Confirm Trip: Y, note the Fault state.
21. If Fault: Y, the underlying fault current must drop below the protection pickup before reset is possible (fault clears automatically when the simulation current drops).
22. Once Fault: N, go to Breaker Control > Reset Trip > OK.
23. Verify Status shows Trip: N. You may now close the breaker.

## 7.5 Viewing Trip History

24. Select the RTU.
25. Navigate to Trip History.
26. The screen shows the last fault type (Phase OC / Earth / None) and the relay time in milliseconds at which the trip occurred.

## 7.6 Remote Control via Modbus TCP

27. Ensure the target RTU is in Remote mode (WARNING LED on, or check register 30004 = 2).
28. Connect a Modbus TCP client to 172.16.1.12:502.
29. Set the Unit ID in the request to the RTU number (1–10).
30. To close the breaker: write 2 to register 40001. Read register 30001 to confirm it reads 2 (Closed).
31. To open the breaker: write 1 to register 40001.
32. To reset a trip: write 1 to register 40002 (only effective when trip is active and fault is clear).

# 8. Troubleshooting

Symptom | Likely Cause & Remedy
LCD shows nothing | Check I²C address (default 0x27); change to 0x3F in Config.h if LCD has different jumper configuration. Verify SDA/SCL wiring on D20/D21.
Buttons not responding | Only one button at a time is supported. Check charlieplex wiring on D11, D12, D13. Button reads are debounced at the 50 ms UI tick interval.
TRIP LED stays on after Reset Trip | The fault (ALARM LED) must clear first. The simulation current must drop below the PTOC pickup before the fault flag resets.
Cannot close breaker via Modbus | Confirm the RTU is in Remote mode (IR 30004 = 2). Confirm no trip or fault is active. Check Unit ID matches RTU number.
Modbus TCP not responding | Verify Ethernet cable and IP configuration (172.16.1.12). The W5500 is on SPI with CS on D10; confirm no SPI bus conflicts.
Measurements always zero | For relay RTUs: the incoming breaker of that busbar must be closed. For voltage RTUs: the incoming feed breaker must be closed before voltages are non-zero.
Unexpected trip on incoming feeder | The incoming relay sums all bay currents. Check each outgoing bay's measurement. A fault on any bay can cause the incoming relay to trip if the total exceeds its pickup.

# 9. Technical Specifications

Parameter | Value
UI refresh rate | 20 Hz (50 ms period)
Protection logic rate | 2 Hz (500 ms period)
ADC sampling rate | 100 Hz (10 ms period, 12 channels)
ADC resolution | 10-bit (Arduino Mega internal ADC)
Modbus TCP port | 502
Max Modbus clients | 8 simultaneous connections
Input registers | 64 (addresses 0–63)
Holding registers | 16 (addresses 0–15)
PIOC pickup (default) | 50 000 (5000.0 A scaled)
PTOC pickup (default) | 5 000 (500.0 A scaled)
PTOC time multiplier (default) | 15
Ethernet MAC | DE:AD:BE:EF:00:01
Default IP address | 172.16.1.12 (static)
Default control mode | Remote (all RTUs)

(c) 2026 — Arduino Mega 2560 Platform Page 15

Protection Relay Simulator User Manual
