robidev/mini_substation_automation/docs/build_steps/0_sets/20250924_161342.min.jpg

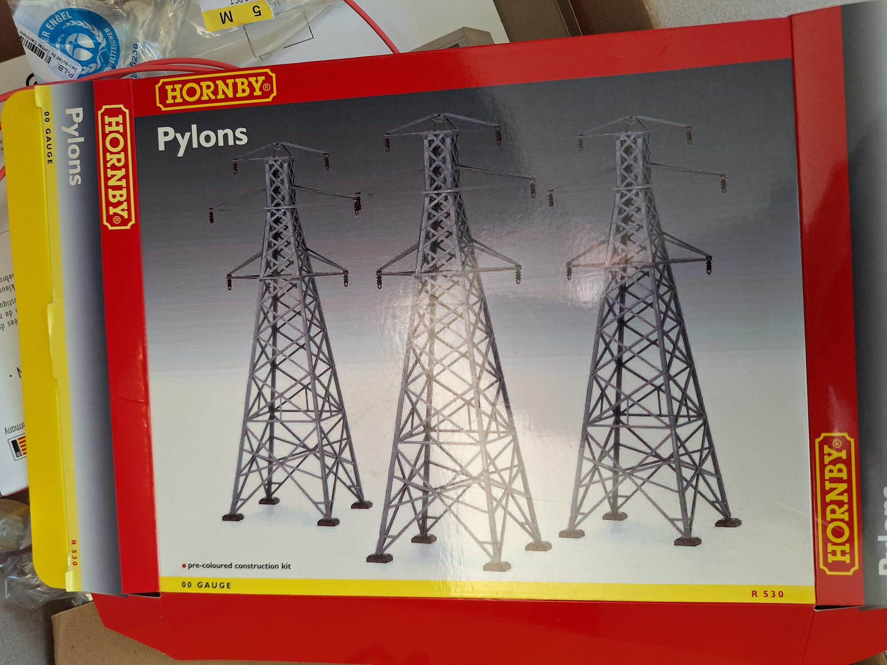
docs/build_steps/0_sets/20250924_161342.min.jpg
