robidev/mini_substation_automation/docs/build_steps/0_sets/faller_130958_2.min.jpg

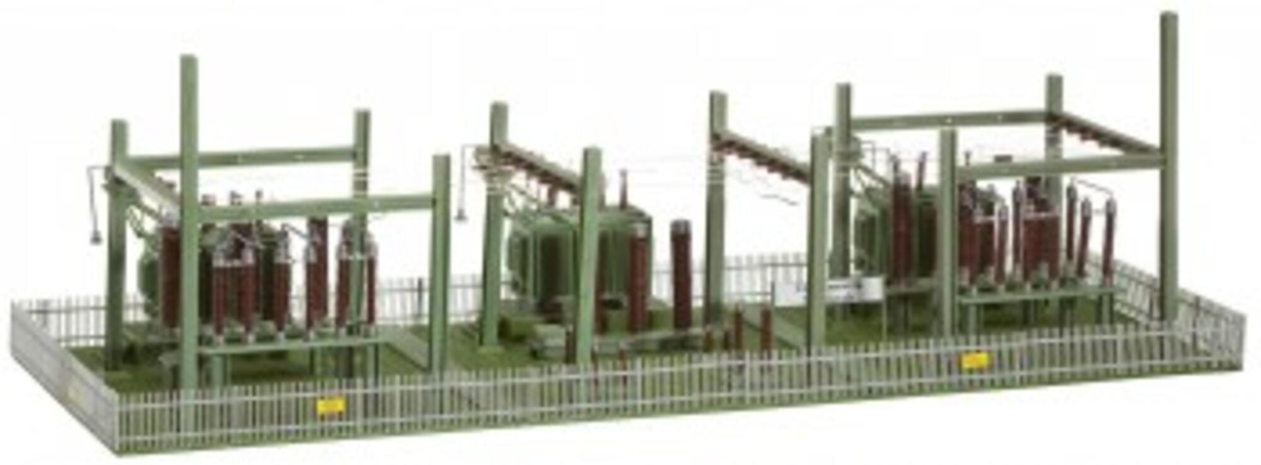
docs/build_steps/0_sets/faller_130958_2.min.jpg
