robidev/mini_substation_automation/docs/build_steps/0_sets/faller_131385.min.jpg

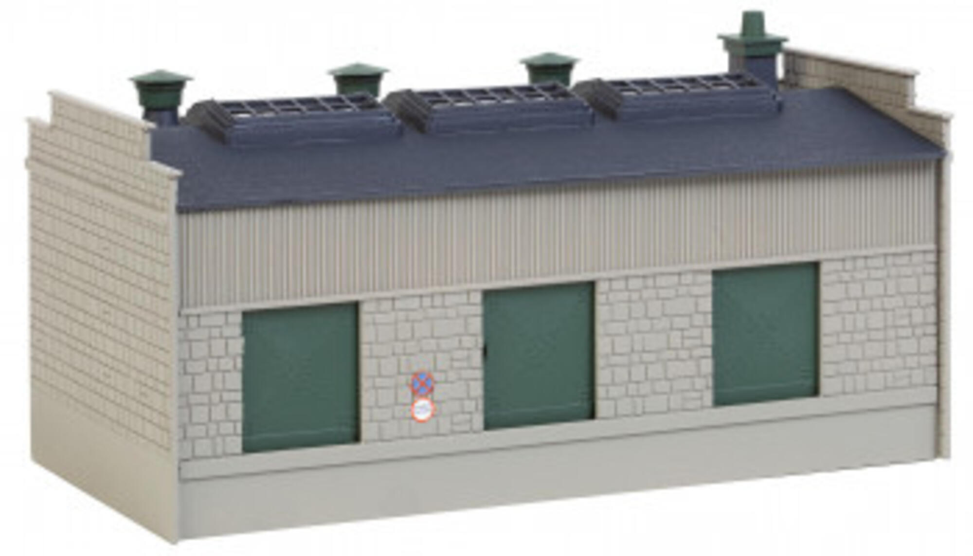
docs/build_steps/0_sets/faller_131385.min.jpg
