robidev/mini_substation_automation/docs/build_steps/0_sets/Screenshot_2026-02-17_21-46-06.png

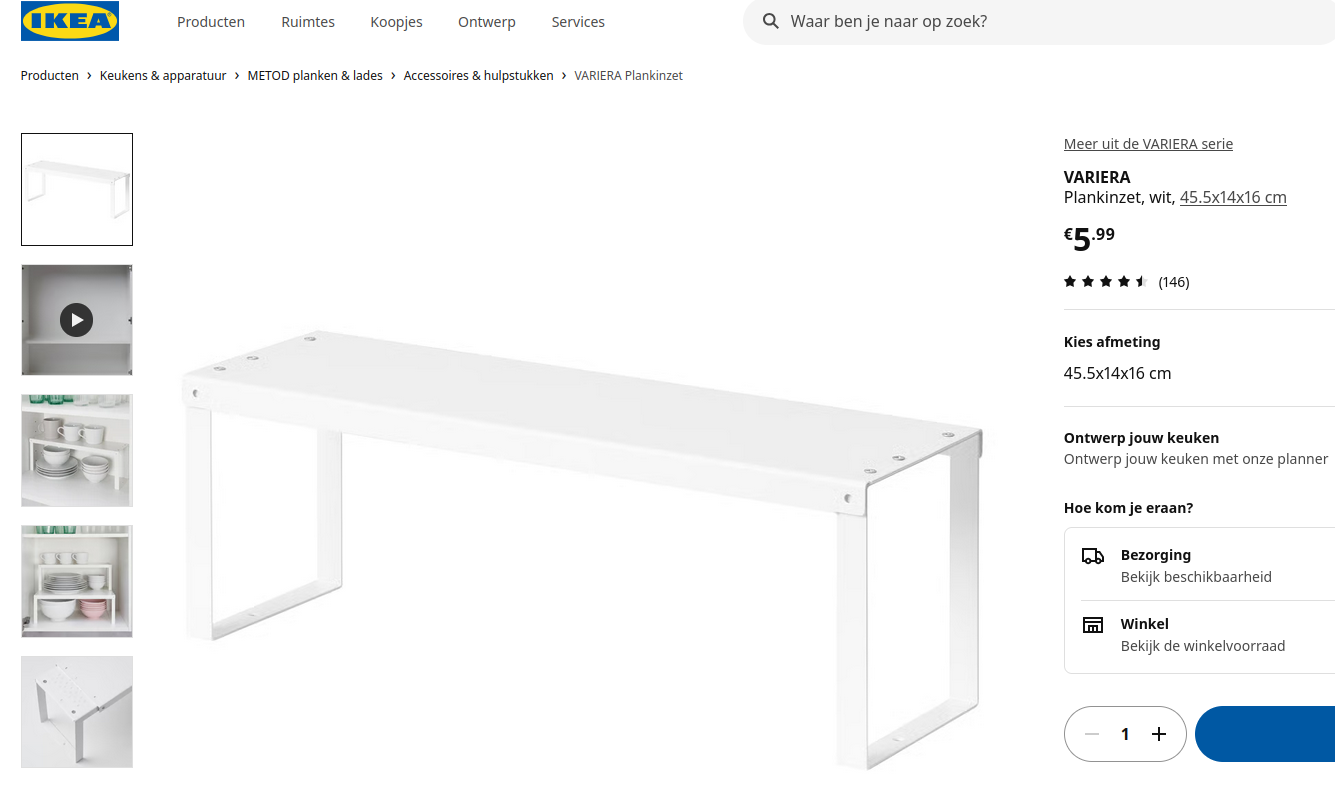
docs/build_steps/0_sets/Screenshot_2026-02-17_21-46-06.png
