robidev/mini_substation_automation/docs/build_steps/1_ms/20250908_180459.min.jpg

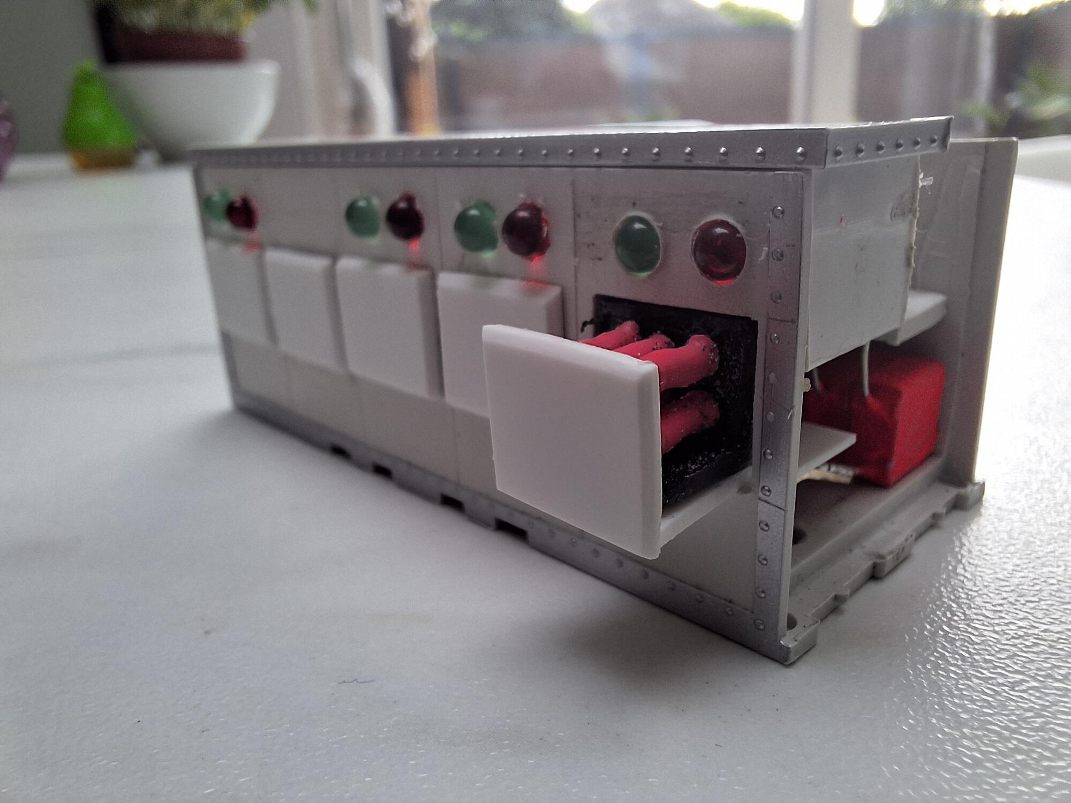
docs/build_steps/1_ms/20250908_180459.min.jpg
