robidev/mini_substation_automation/docs/build_steps/1_ms/20250908_210415.min.jpg

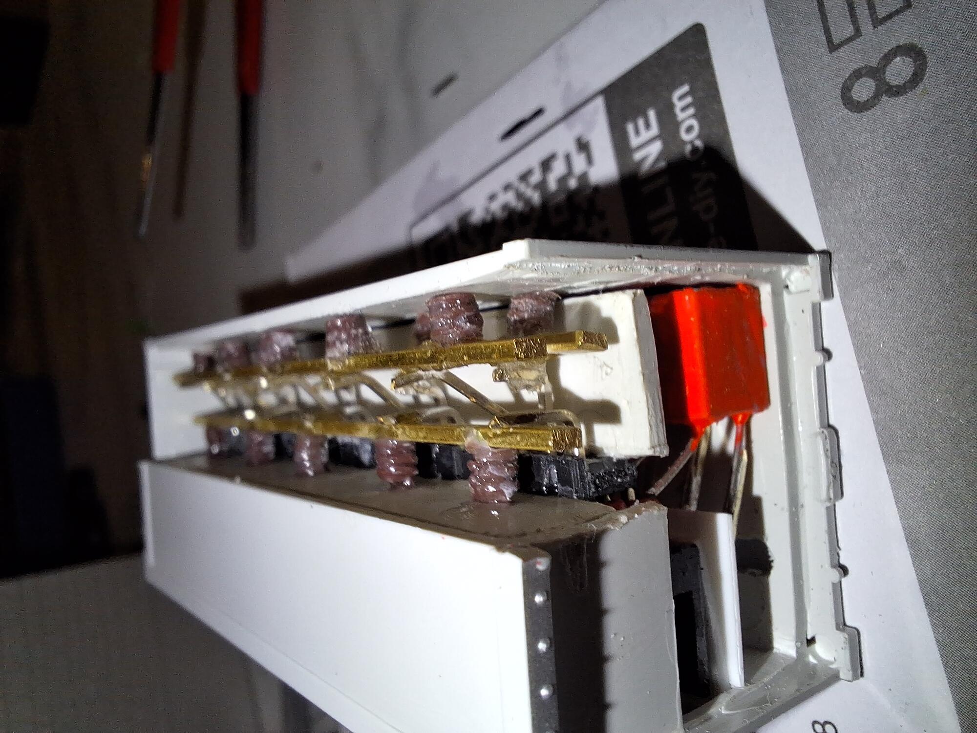
docs/build_steps/1_ms/20250908_210415.min.jpg
