robidev/mini_substation_automation/docs/build_steps/1_ms/20250911_223326.min.jpg

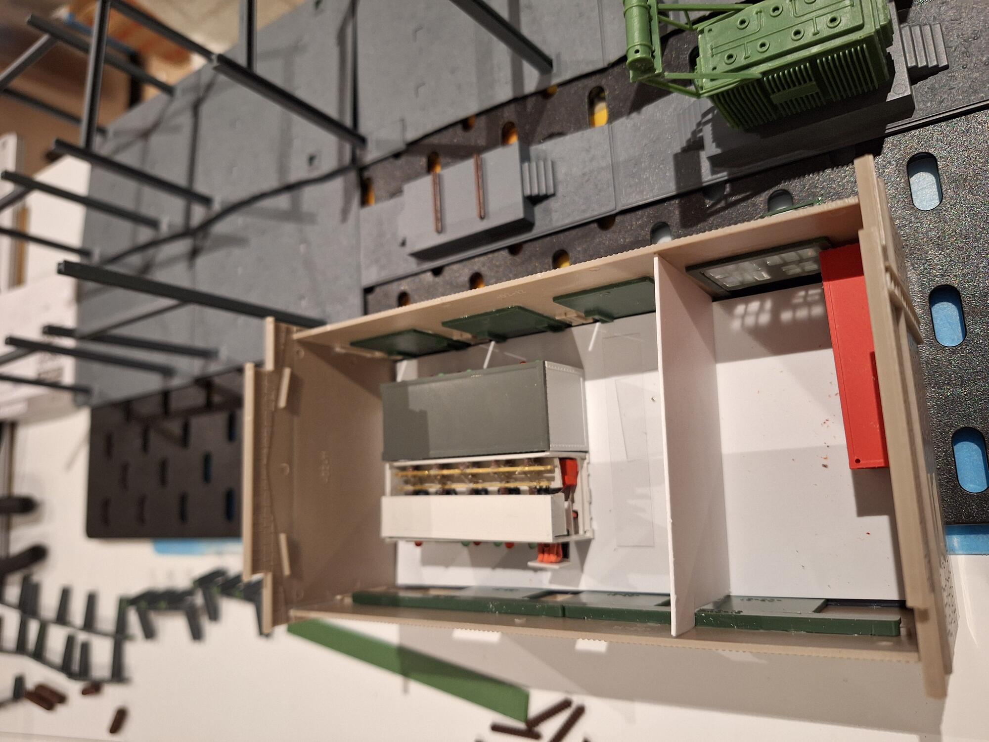
docs/build_steps/1_ms/20250911_223326.min.jpg
