robidev/mini_substation_automation/docs/build_steps/1_ms/20251004_214540.min.jpg

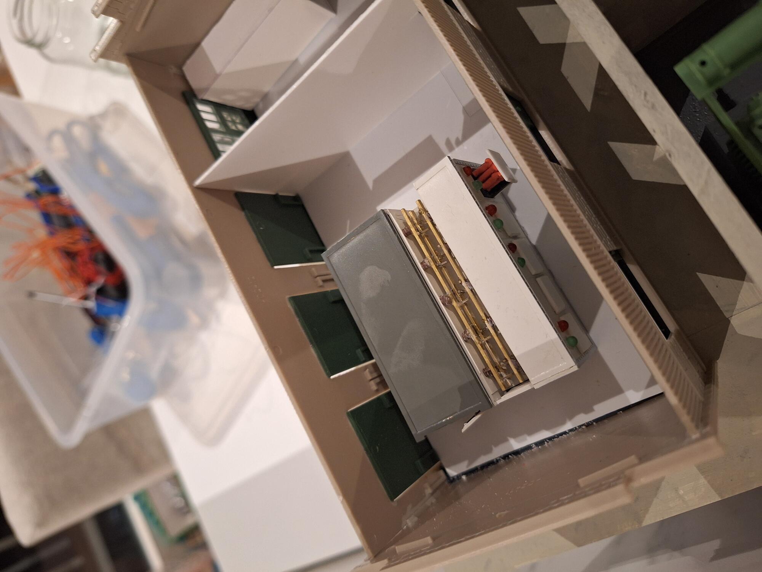
docs/build_steps/1_ms/20251004_214540.min.jpg
