robidev/mini_substation_automation/docs/build_steps/1_ms/20251019_193410.min.jpg

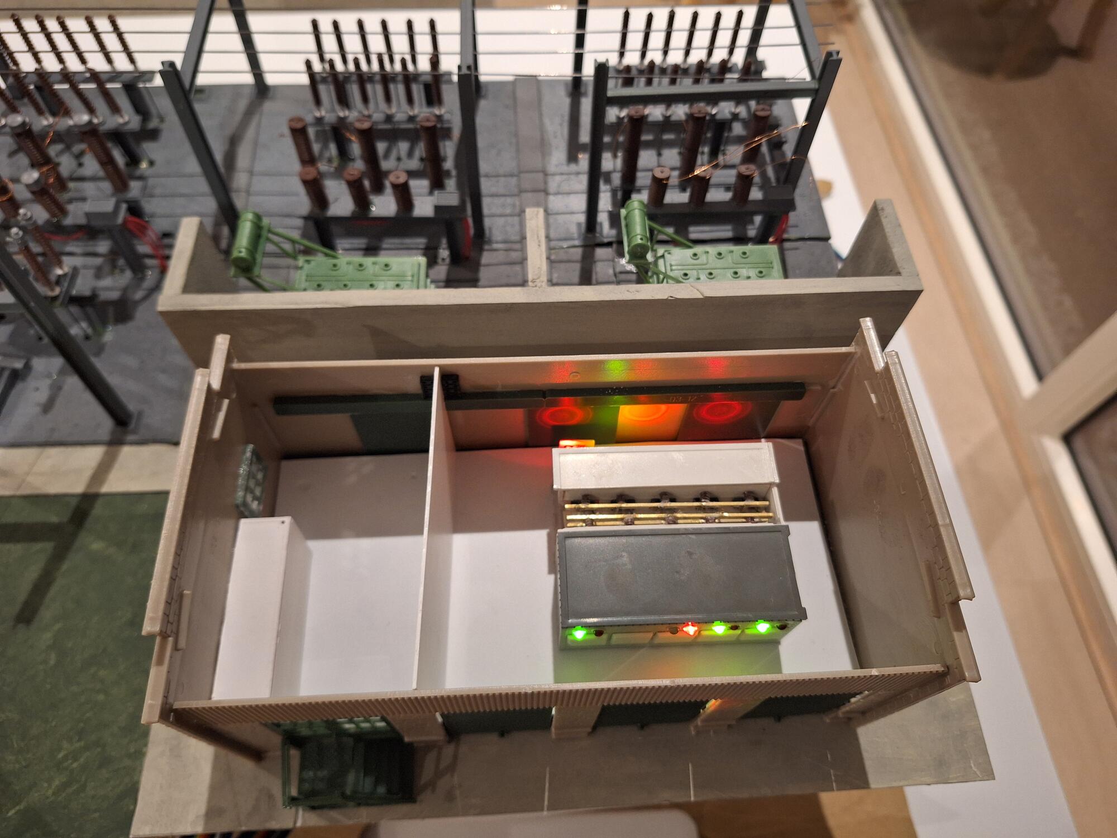
docs/build_steps/1_ms/20251019_193410.min.jpg
