robidev/mini_substation_automation/docs/build_steps/1_ms/20251230_193729.min.jpg

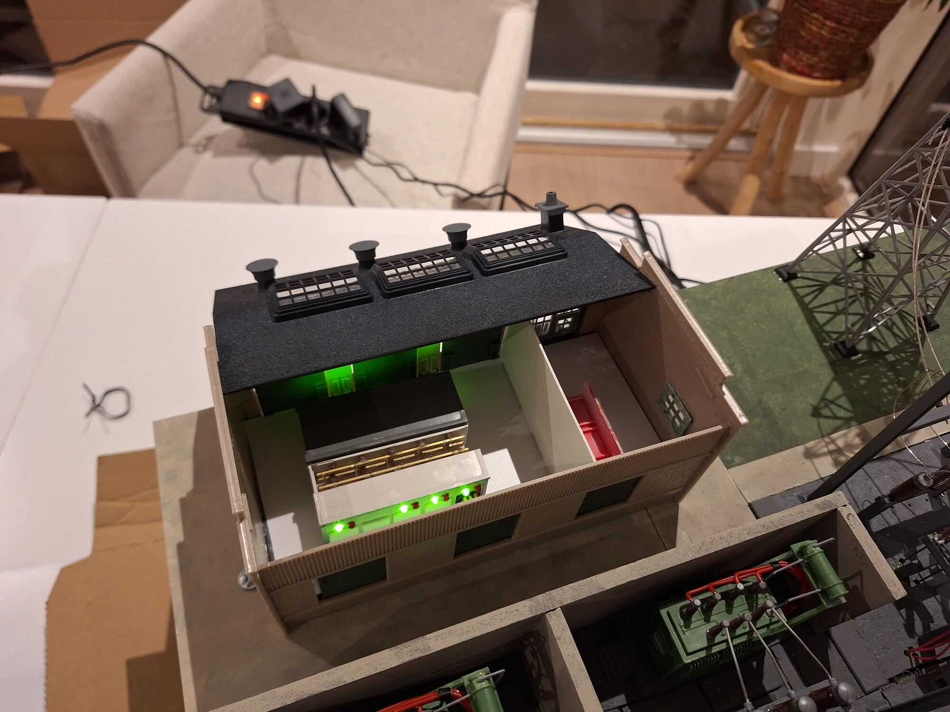
docs/build_steps/1_ms/20251230_193729.min.jpg
