robidev/mini_substation_automation/docs/build_steps/3_baseplate/20250910_225503.min.jpg

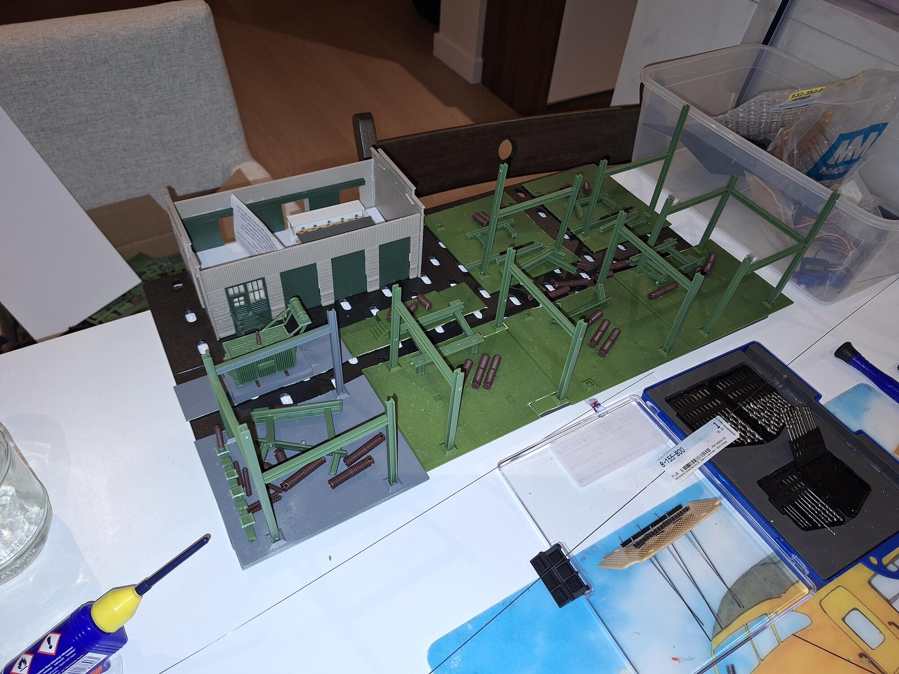
docs/build_steps/3_baseplate/20250910_225503.min.jpg
