robidev/mini_substation_automation/docs/build_steps/3_baseplate/20250911_125659.min.jpg

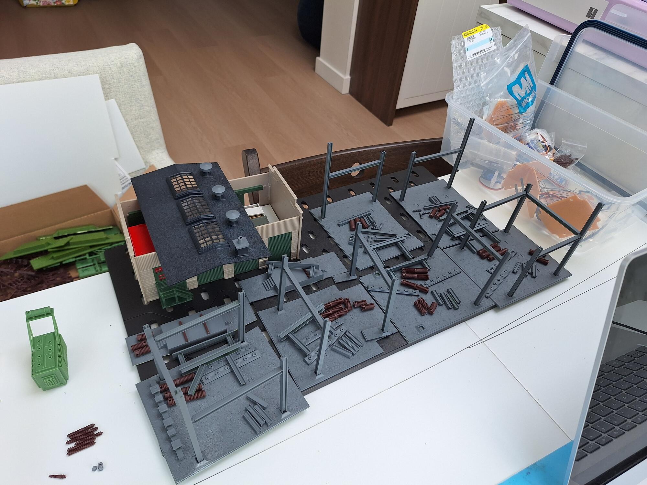
docs/build_steps/3_baseplate/20250911_125659.min.jpg
