robidev/mini_substation_automation/docs/build_steps/3_baseplate/20250911_223241.min.jpg

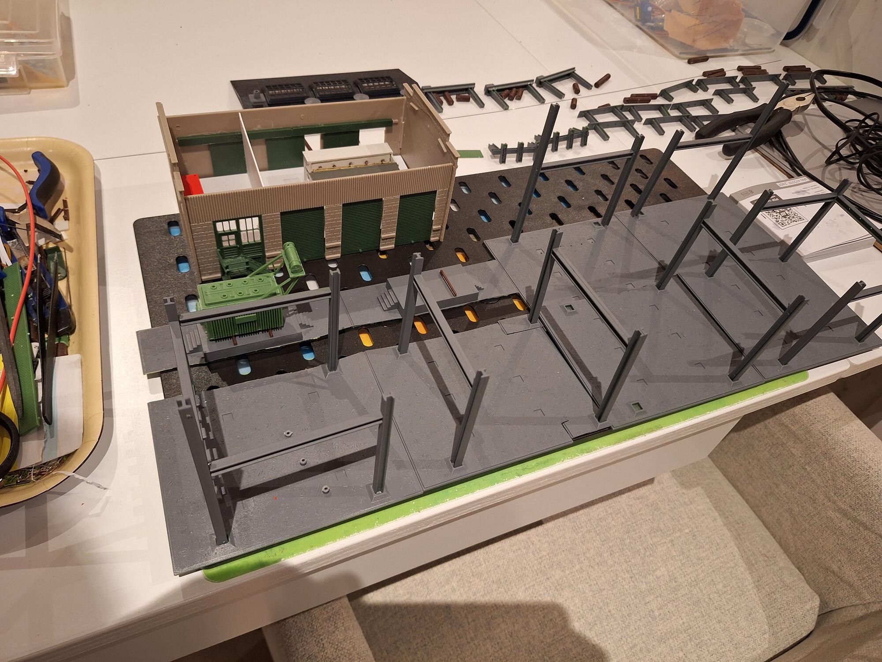
docs/build_steps/3_baseplate/20250911_223241.min.jpg
