robidev/mini_substation_automation/docs/build_steps/3_baseplate/20250911_223248.min.jpg

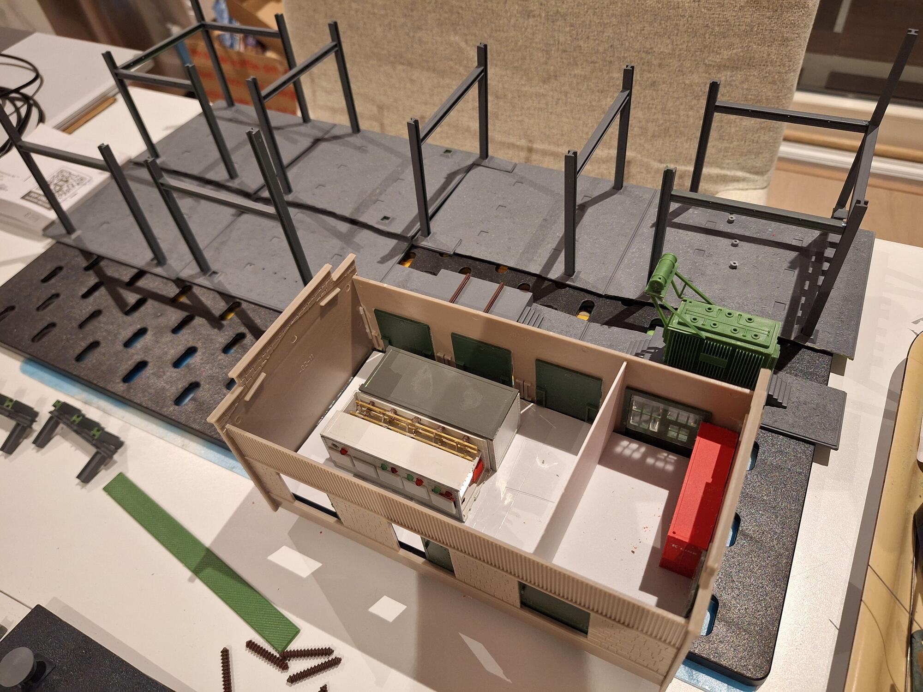
docs/build_steps/3_baseplate/20250911_223248.min.jpg
