robidev/mini_substation_automation/docs/build_steps/3_baseplate/20250912_213349.min.jpg

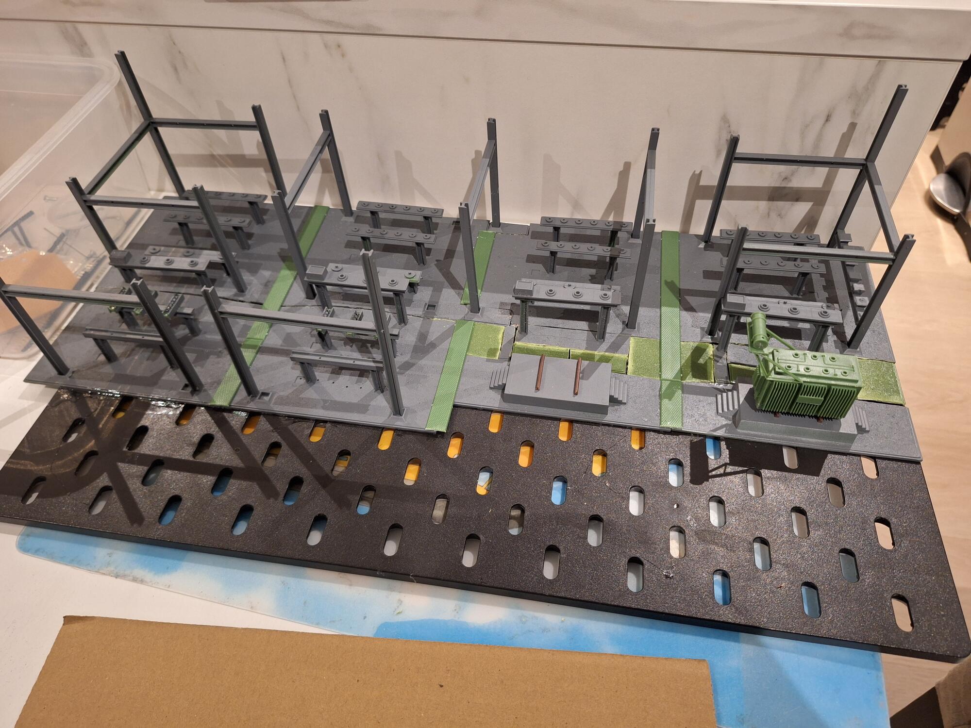
docs/build_steps/3_baseplate/20250912_213349.min.jpg
