robidev/mini_substation_automation/docs/build_steps/3_baseplate/20250917_221405.min.jpg

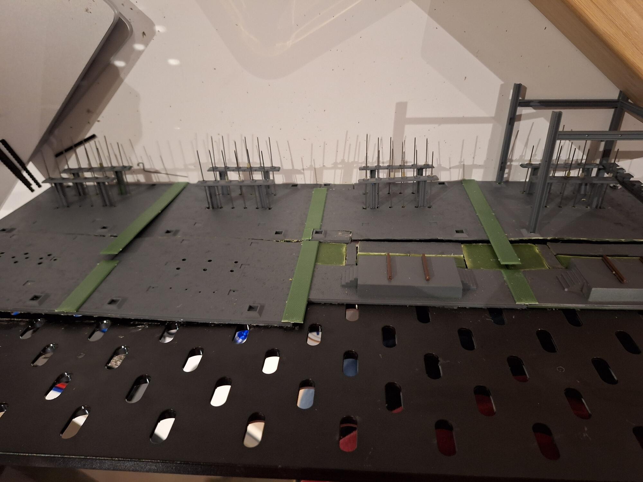
docs/build_steps/3_baseplate/20250917_221405.min.jpg
