robidev/mini_substation_automation/docs/build_steps/3_baseplate/20251001_210243.min.jpg

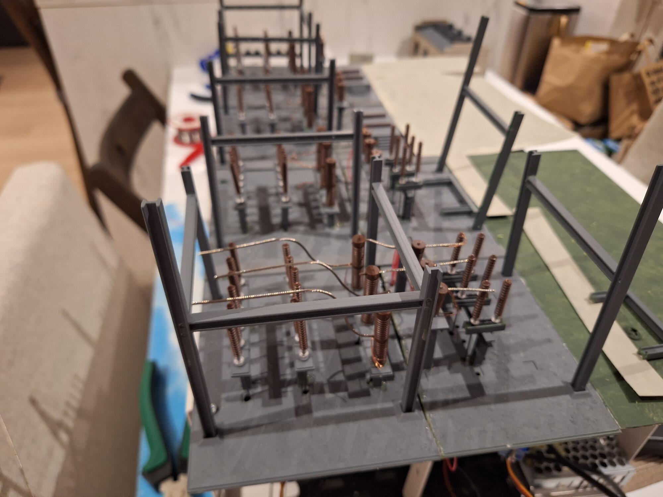
docs/build_steps/3_baseplate/20251001_210243.min.jpg
