robidev/mini_substation_automation/docs/build_steps/3_baseplate/20251002_221014.min.jpg

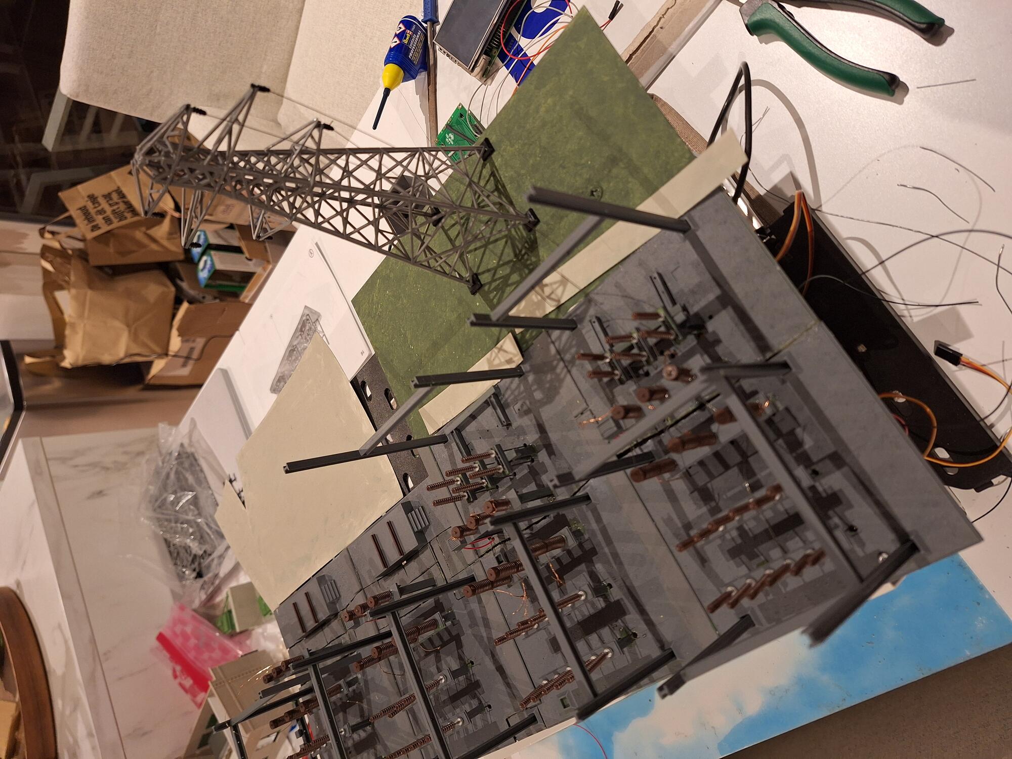
docs/build_steps/3_baseplate/20251002_221014.min.jpg
