robidev/mini_substation_automation/docs/build_steps/3_baseplate/20251004_211208.min.jpg

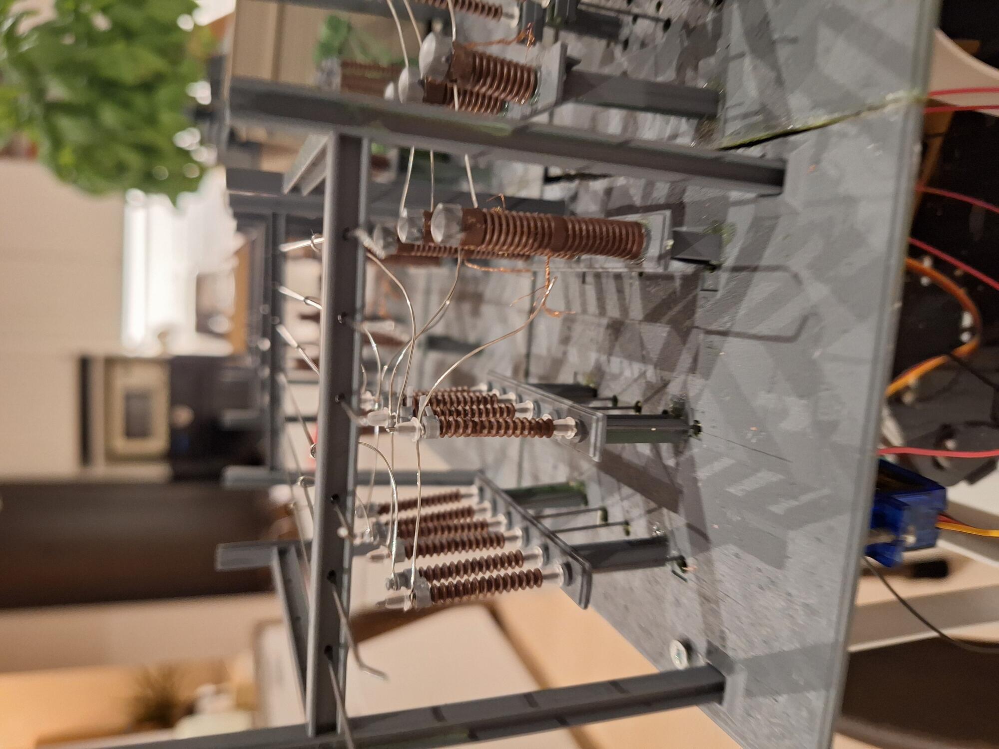
docs/build_steps/3_baseplate/20251004_211208.min.jpg
