robidev/mini_substation_automation/docs/build_steps/3_baseplate/20251004_214515.min.jpg

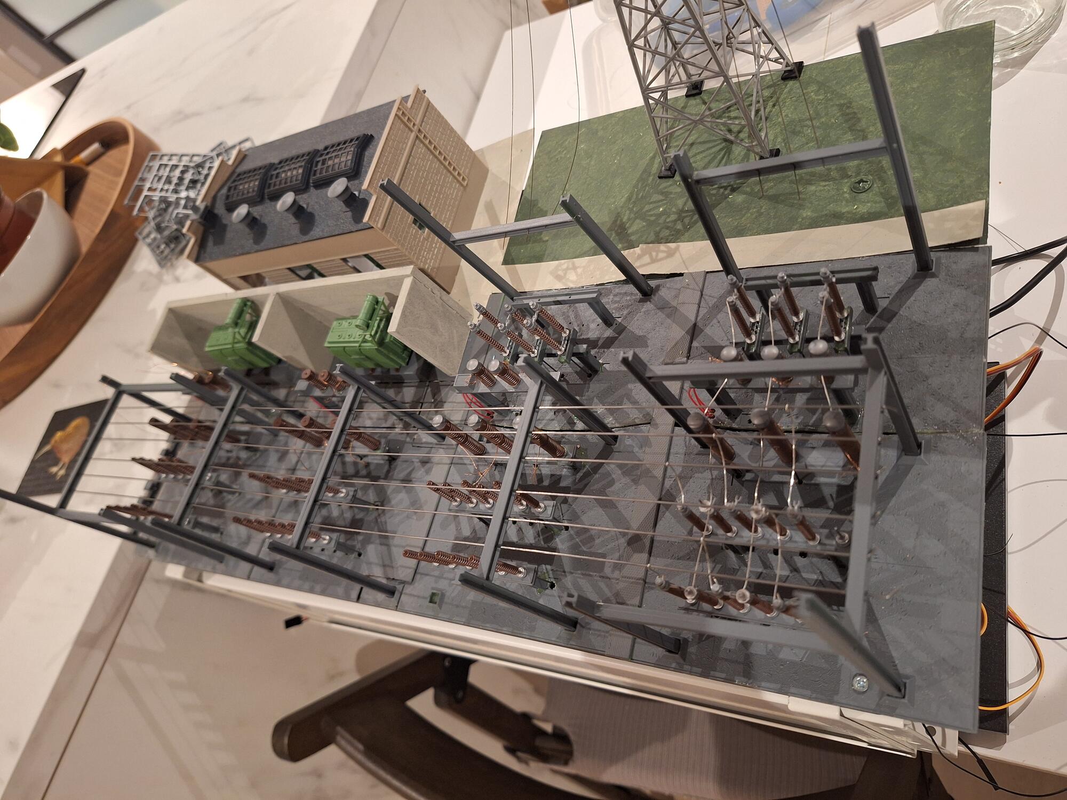
docs/build_steps/3_baseplate/20251004_214515.min.jpg
