robidev/mini_substation_automation/docs/build_steps/3_baseplate/20251109_223542.min.jpg

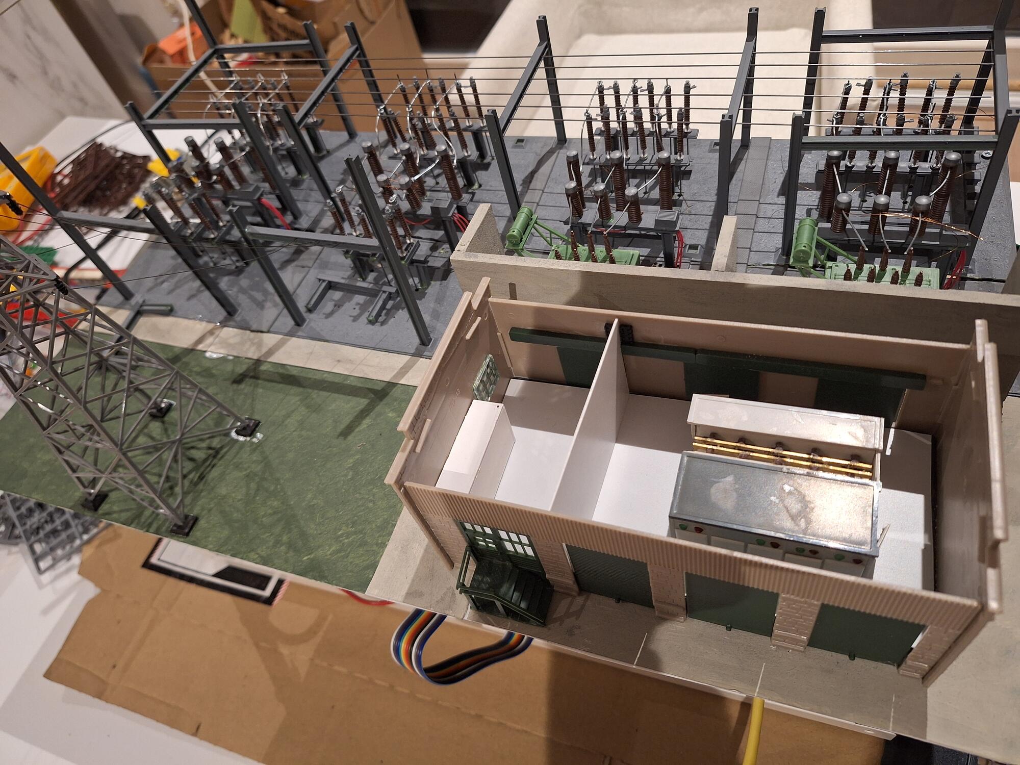
docs/build_steps/3_baseplate/20251109_223542.min.jpg
