robidev/mini_substation_automation/docs/build_steps/3_baseplate/20251110_220945.min.jpg

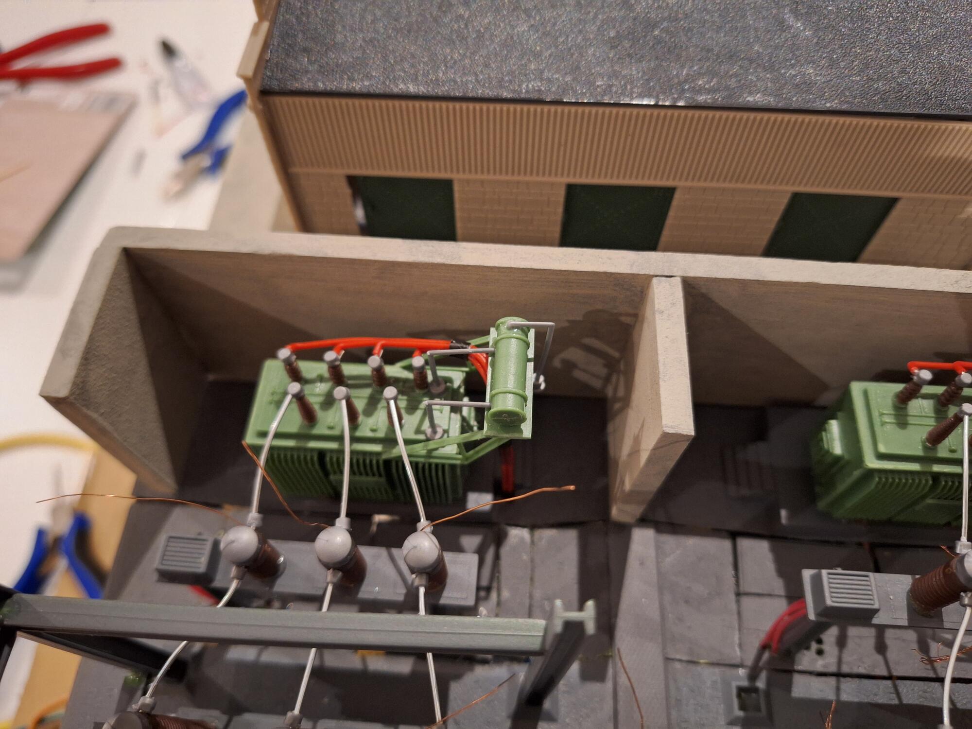
docs/build_steps/3_baseplate/20251110_220945.min.jpg
