robidev/mini_substation_automation/docs/build_steps/3_baseplate/20251111_225937.min.jpg

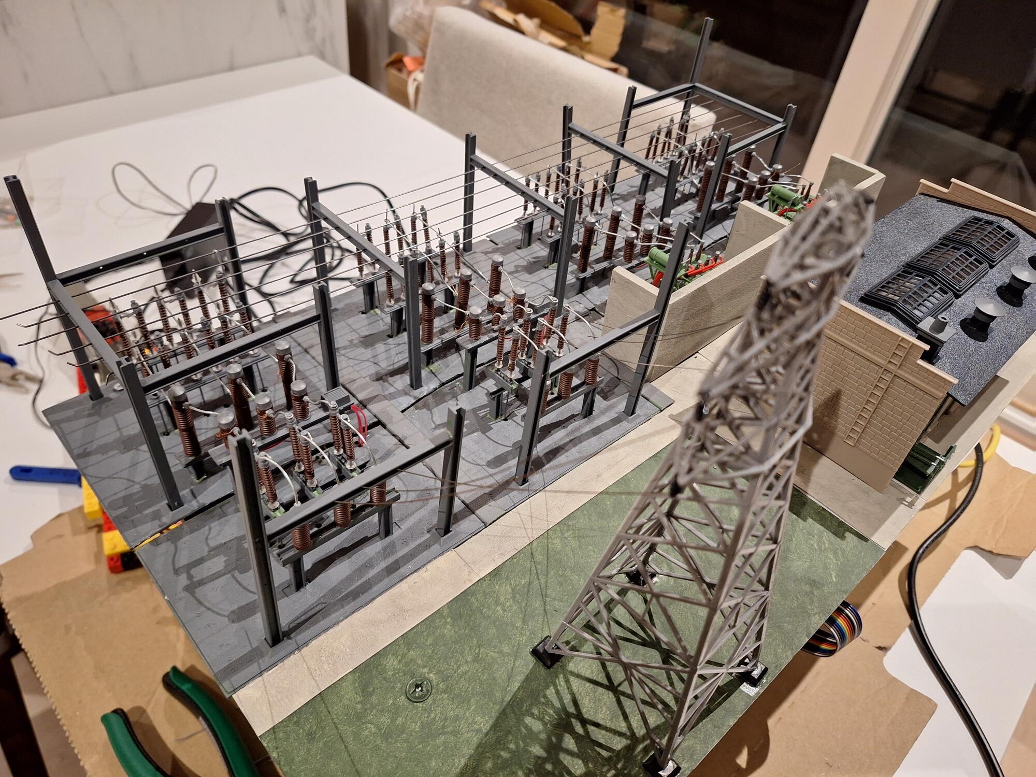
docs/build_steps/3_baseplate/20251111_225937.min.jpg
