robidev/mini_substation_automation/docs/build_steps/3_baseplate/20251111_225957.min.jpg

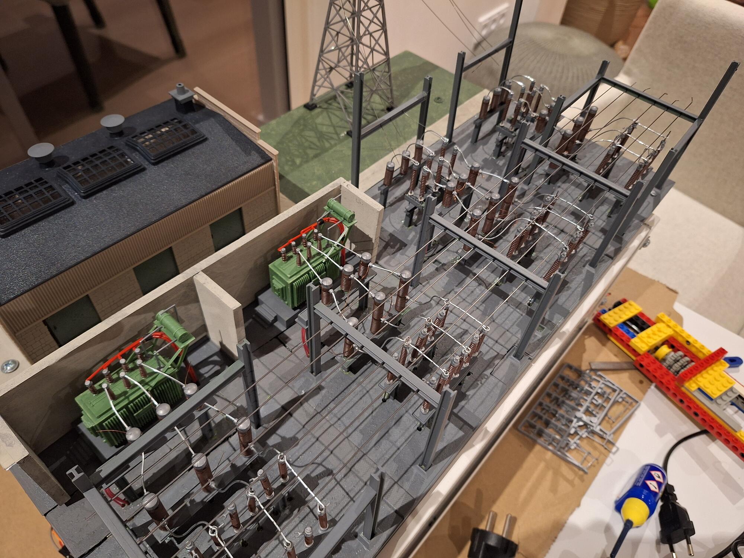
docs/build_steps/3_baseplate/20251111_225957.min.jpg
