robidev/mini_substation_automation/docs/build_steps/3_baseplate/20251114_231127.min.jpg

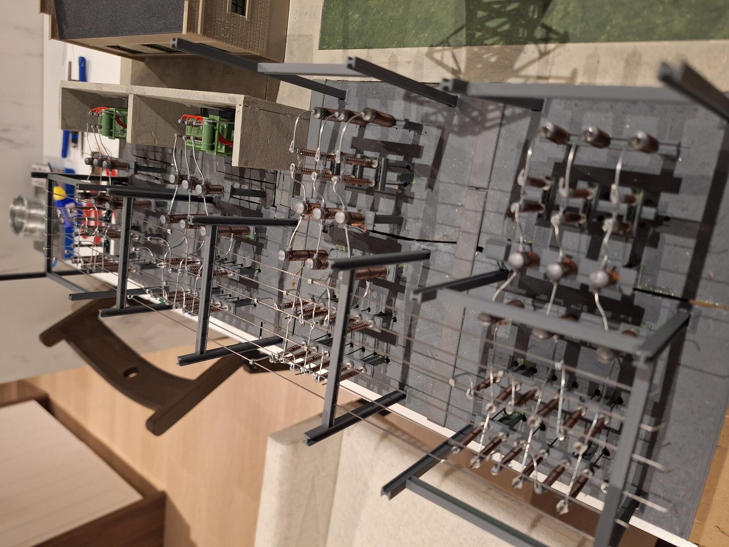
docs/build_steps/3_baseplate/20251114_231127.min.jpg
