robidev/mini_substation_automation/docs/build_steps/3_baseplate/20251116_213941.min.jpg

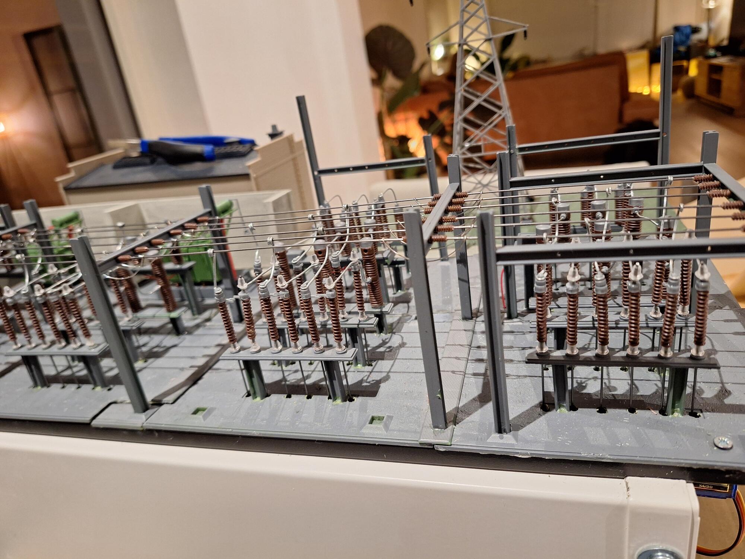
docs/build_steps/3_baseplate/20251116_213941.min.jpg
