robidev/mini_substation_automation/docs/build_steps/3_baseplate/20251116_214119.min.jpg

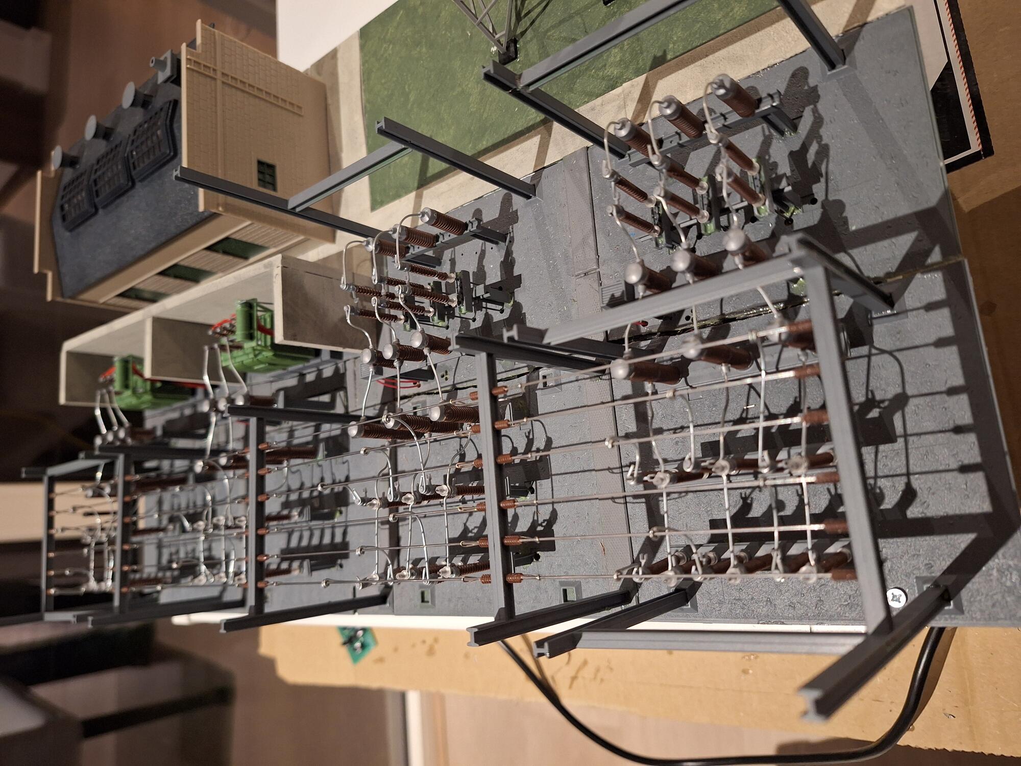
docs/build_steps/3_baseplate/20251116_214119.min.jpg
