robidev/mini_substation_automation/docs/build_steps/3_baseplate/20251126_230228.min.jpg

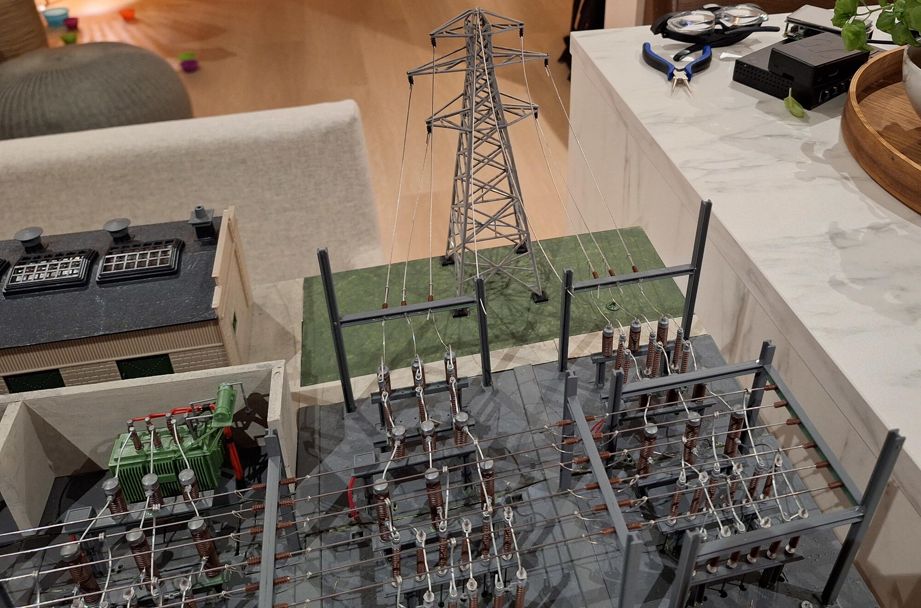
docs/build_steps/3_baseplate/20251126_230228.min.jpg
