robidev/mini_substation_automation/docs/build_steps/5_front/20251019_193225.min.jpg

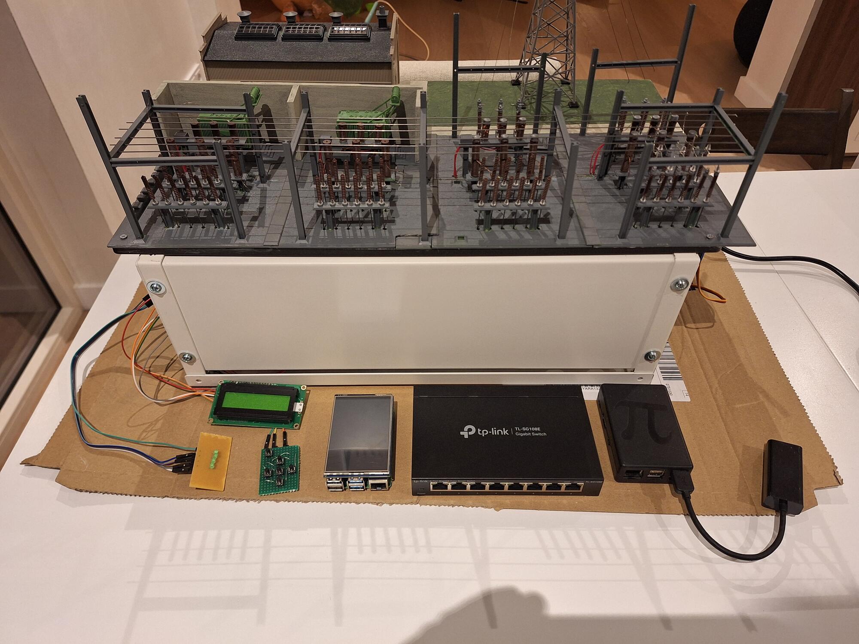
docs/build_steps/5_front/20251019_193225.min.jpg
