robidev/mini_substation_automation/docs/build_steps/5_front/20251120_185948.min.jpg

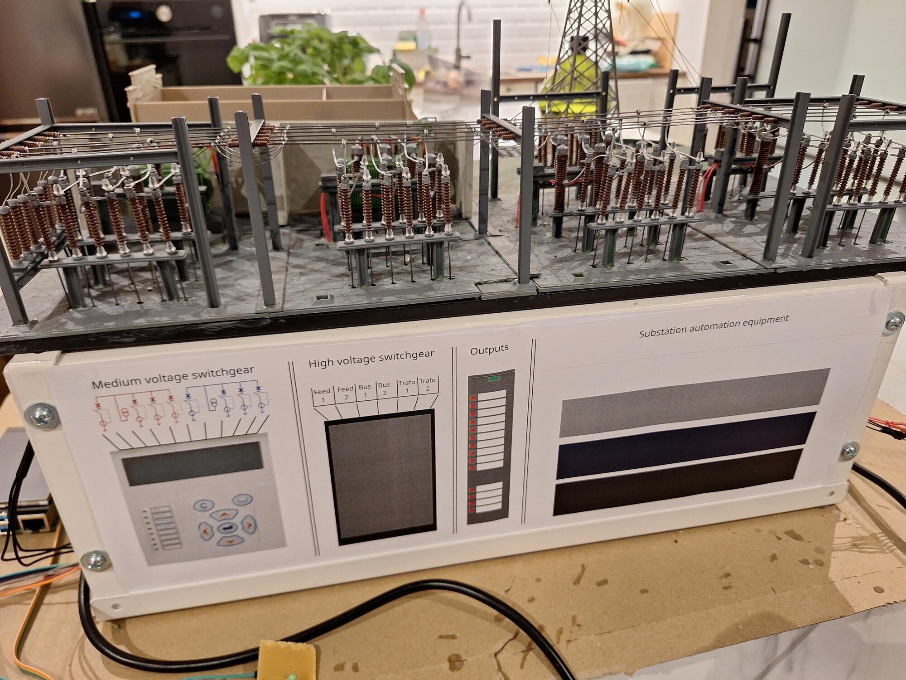
docs/build_steps/5_front/20251120_185948.min.jpg
