robidev/mini_substation_automation/docs/build_steps/5_front/20251126_230604.min.jpg

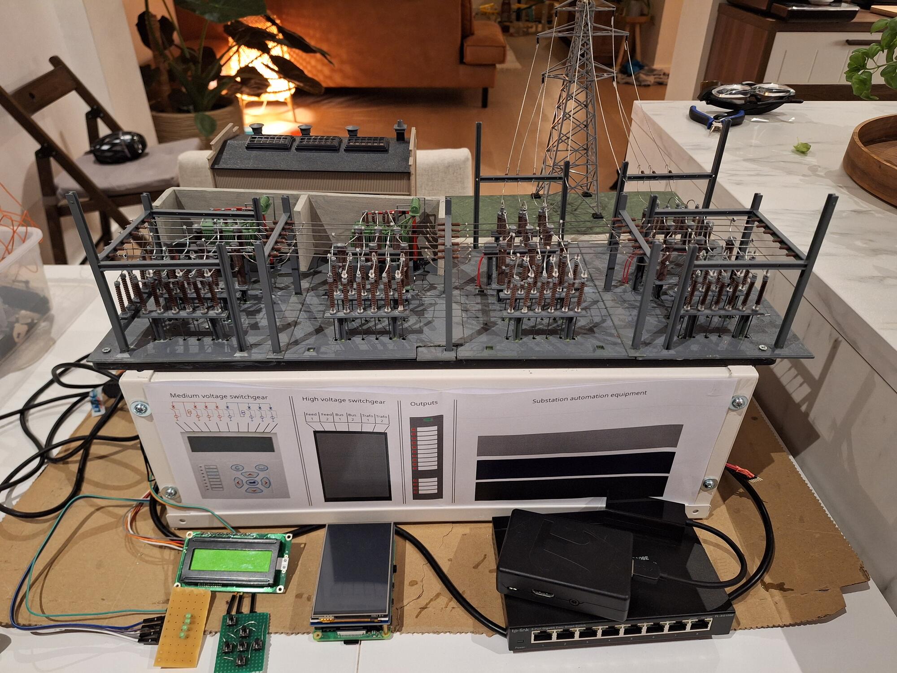
docs/build_steps/5_front/20251126_230604.min.jpg
