robidev/mini_substation_automation/docs/build_steps/5_front/20251230_193745.min.jpg

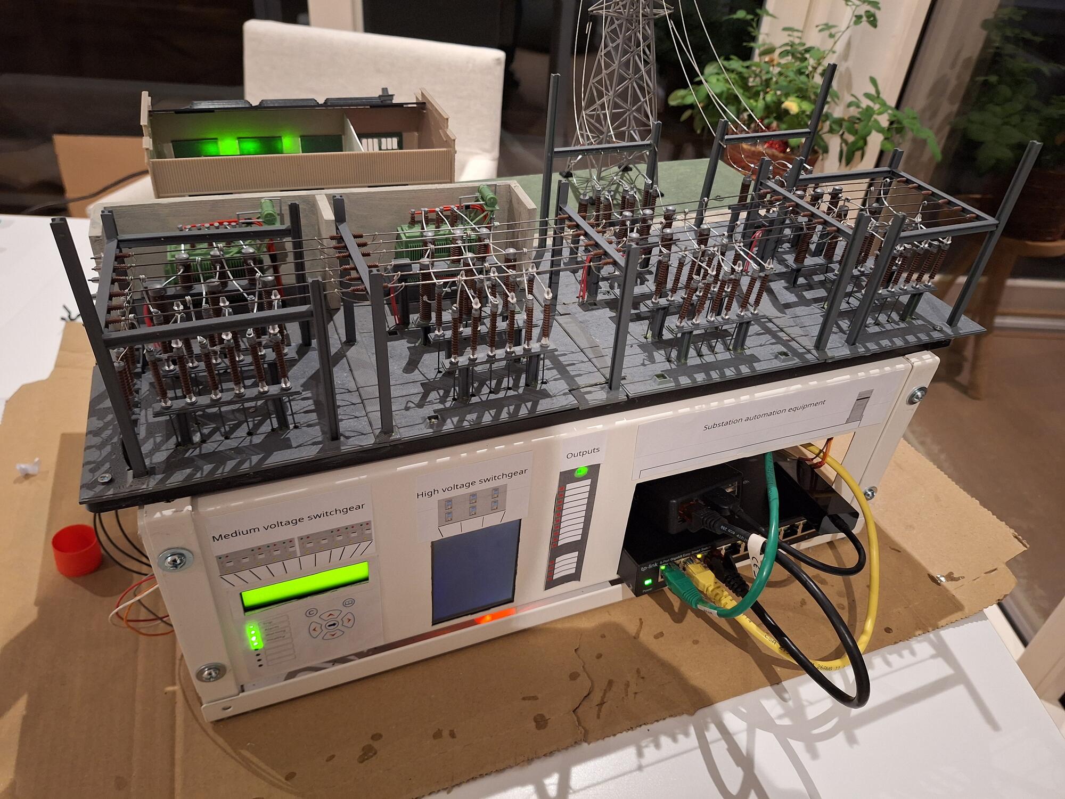
docs/build_steps/5_front/20251230_193745.min.jpg
