robidev/mini_substation_automation/docs/build_steps/5_front/20260111_105248.min.jpg

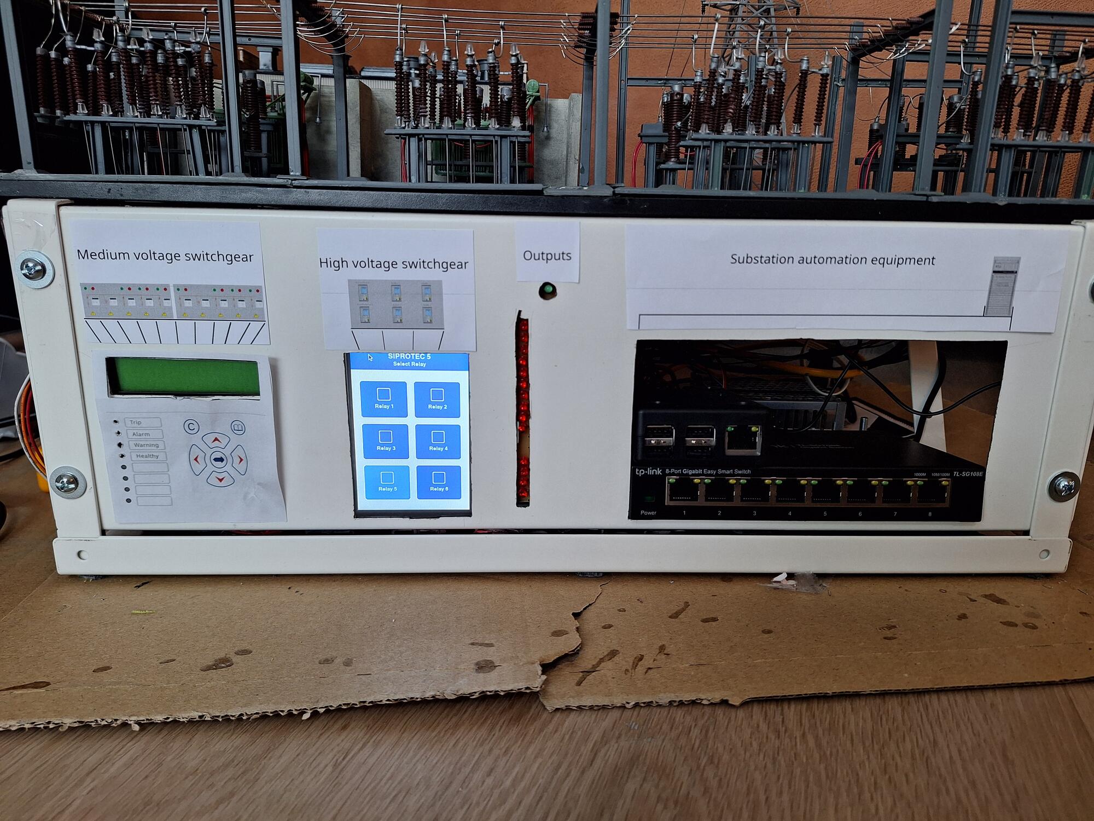
docs/build_steps/5_front/20260111_105248.min.jpg
