robidev/mini_substation_automation/scripts/deployment/todo_ansible_playbooks.txt

desc to program rpi's

hs01:

cmdline.txt
-----------
coherent_pool=1M 8250.nr_uarts=1 snd_bcm2835.enable_headphones=0 cgroup_disable=memory snd_bcm2835.enable_headphones=0 snd_bcm2835.enable_hdmi=0 snd_bcm2835.enable_hdmi=0  vc_mem.mem_base=0x3ec00000 vc_mem.mem_size=0x40000000  console=tty1 root=PARTUUID=c6f6dcdd-02 rootfstype=ext4 fsck.repair=yes rootwait quiet splash plymouth.ignore-serial-consoles cfg80211.ieee80211_regdom=NL

	raspi-config -> enable i2c, enable serial
	nmtui

	mkdir hscontrol

	python -m venv .
	libs:
		Adafruit-Blinka==8.67.0
		adafruit-circuitpython-busdevice==5.2.14
		adafruit-circuitpython-connectionmanager==3.1.6
		adafruit-circuitpython-motor==3.4.18
		adafruit-circuitpython-pca9685==3.4.20
		adafruit-circuitpython-register==1.11.1
		adafruit-circuitpython-requests==4.1.15
		adafruit-circuitpython-servokit==1.3.22
		adafruit-circuitpython-typing==1.12.3
		Adafruit-PlatformDetect==3.84.1
		Adafruit-PureIO==1.1.11
		pyserial==3.5
		RPi.GPIO==0.7.1

	deploy calibrate.py
	deploy testgpio.py

desc to program arduino
on hs01:

curl -fsSL https://raw.githubusercontent.com/arduino/arduino-cli/master/install.sh | bash
sudo mv bin/arduino-cli /usr/local/bin/
arduino-cli config init
mkdir arduino_firmware
cd arduino_firmware/
arduino-cli sketch new testadcserial
cd testadcserial/
arduino-cli core update-index
arduino-cli board list
arduino-cli core install arduino:avr

arduino-cli lib update-index
arduino-cli lib install ArduinoModbus

desc to config switch
desc to install HMI
desc to deploy SCADA
