robidev/mini_substation_automation/TODO.txt

issues:
short matrix werkt anders
phasor werkt wat vreemd, goed doortesten 
VTR-feedback werkt vreemd. 1 scheider bij TR1/2 gesloten zorgde voor spanning op andere bus?
value scaling

NICE:   indicate hw-pi service running????
        NTP timeserver op gtw

[SCADA]
make central SCADA display-> draw HS incomer, MS outgoing, and a few MSR/houses
also add all to gismap
test all signals
maybe some alarms for open breaker?
