robidev/mini_substation_automation/(commit log)

2025-12-15 added drawings and arduino firmware
2026-01-01 added hw config
    [hs01_config.txt, rly_config.txt]
2026-01-05 relay config
    [hs01_config.txt, rly_config.txt, servo_limits.json]
2026-01-10 arduino firmware alpha bugfix and hs01 service
    [servo_limits.json, servo_limits_max.json]
2026-01-11 updated rly socket service
2026-02-08 improved relay ui code
2026-02-09 fixed decoding of ui-connector messages
2026-02-12 fixed serial mock bug, and relay client
    [serial_mock.py]
2026-02-16 added 6 channels for MS current matching, and increased buffer size for upstream messages
2026-02-27 updated frontpanel based on print
2026-02-28 alpha version of arduino, HS and rly coming toghether
    [hs01_config.txt, servo_limits.json]
2026-03-01 fixed LED mapping bug
    [Config.h, Pins.h]
2026-03-09 several fixes, and cleanup
    [service.py]
2026-03-16 fixed modbus bug in arduino
    [ModbusSrv.cpp]
2026-03-18 restructured codebase
    [BUS1.cfg, BUS2.cfg, FEED1.cfg, FEED2.cfg, TR1.cfg, TR2.cfg, hs01_config_steps.txt, servo_limits.json]
